Thrathra/Speeduino-Daytona/Documentation/F107VC_pinout.png

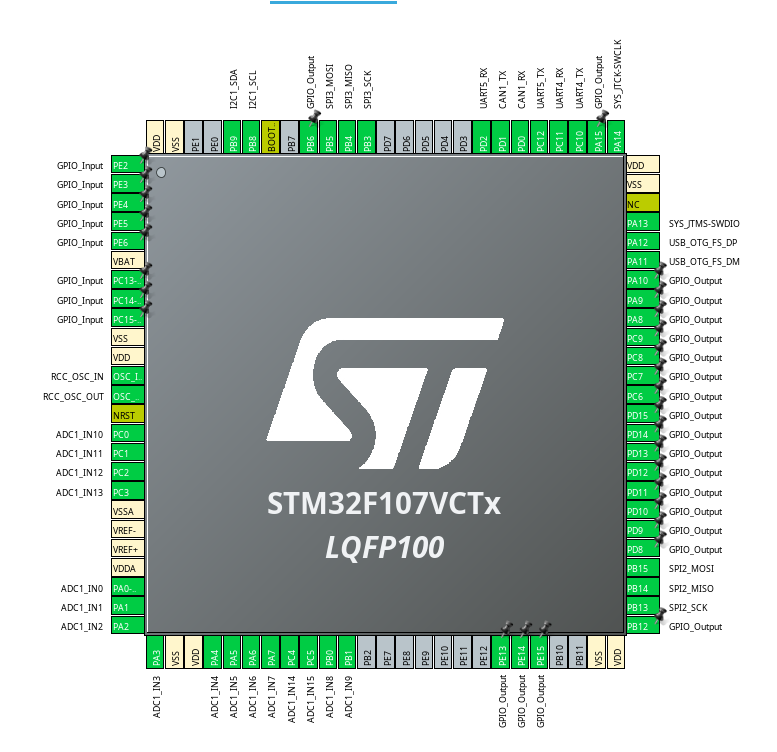
Documentation/F107VC_pinout.png
