Thrathra/Speeduino-Daytona/speeday.kicad_pcb

## KiCad design speeday.kicad_pcb (2026-07-01)

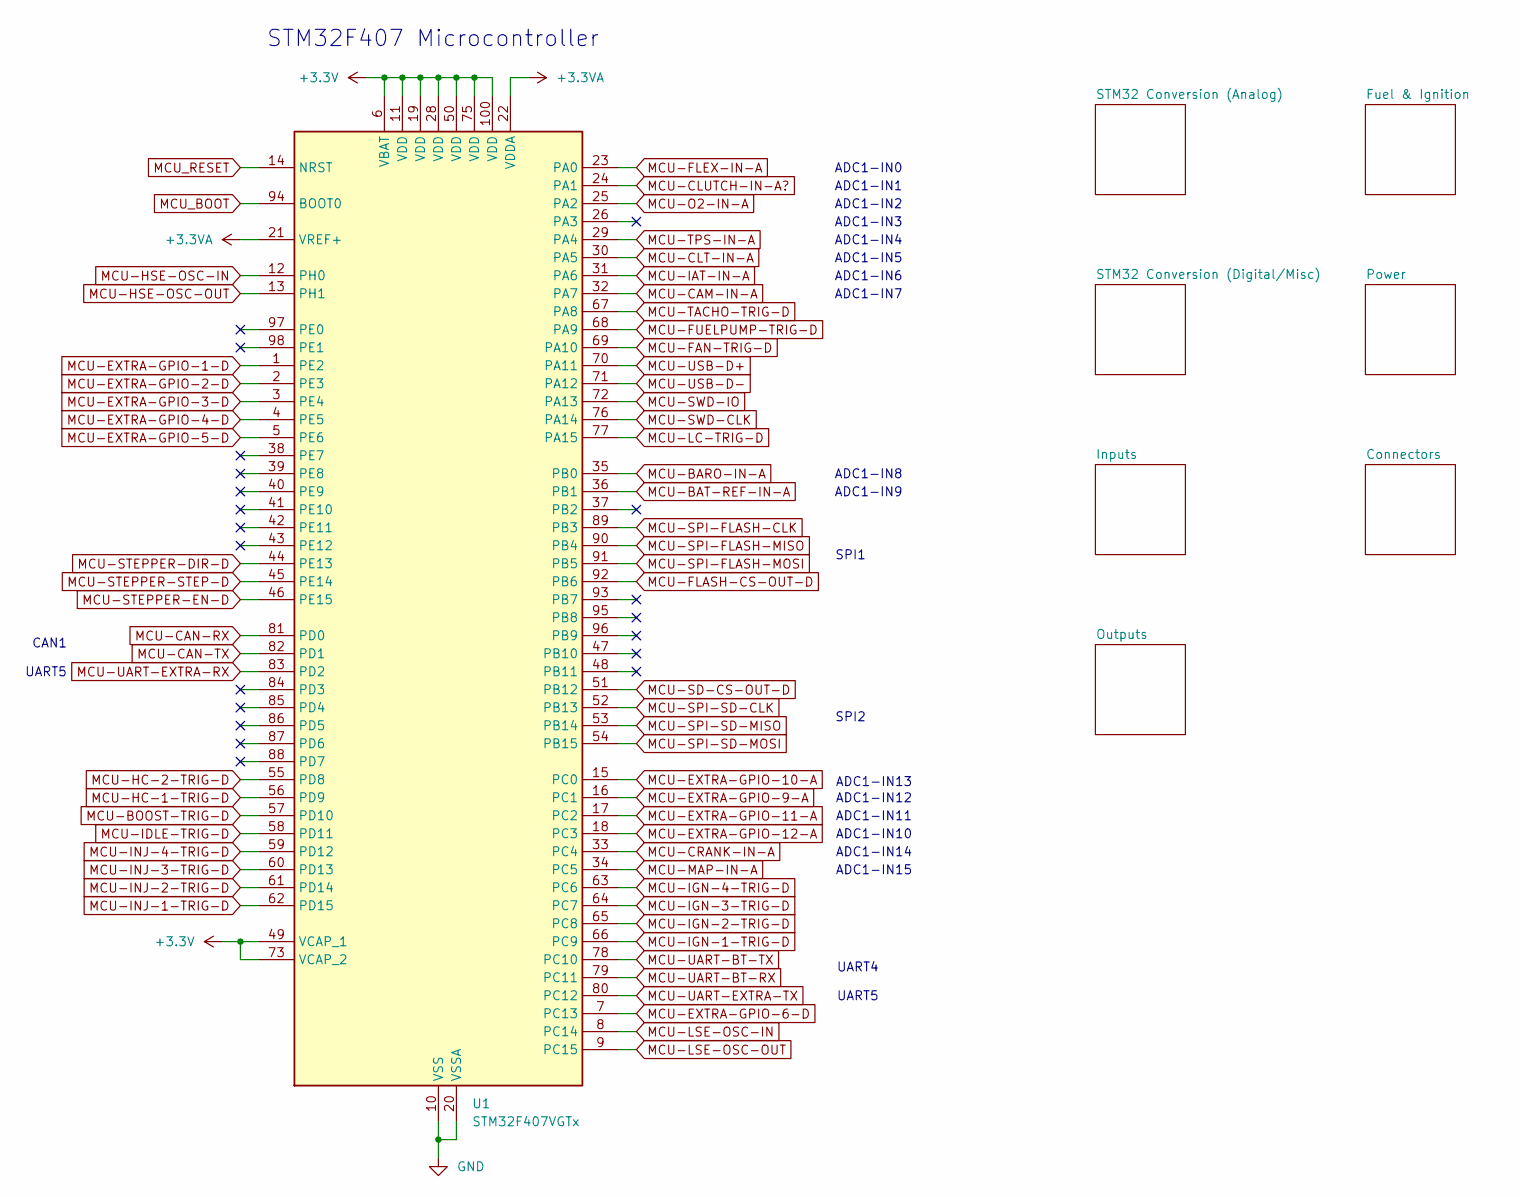
[picture p2: schematic speeday.kicad_sch, 0.4]

Parts:
U1: STM32F407VGTx; LQFP-100_14x14mm_P0.5mm

Connections:
+3.3V: U1.6 (VBAT), U1.11 (VDD), U1.19 (VDD), U1.28 (VDD), U1.49 (VCAP_1), U1.50 (VDD), U1.73 (VCAP_2), U1.75 (VDD), U1.100 (VDD); also elsewhere on the board
+3.3VA: U1.21 (VREF+), U1.22 (VDDA); also elsewhere on the board
GND: U1.10 (VSS), U1.20 (VSSA), U1.27 (VSS), U1.74 (VSS), U1.99 (VSS); also elsewhere on the board
MCU-BARO-IN-A: U1.35 (PB0); also elsewhere on the board
MCU-BAT-REF-IN-A: U1.36 (PB1); also elsewhere on the board
MCU-BOOST-TRIG-D: U1.57 (PD10); also elsewhere on the board
MCU-CAM-IN-A: U1.32 (PA7); also elsewhere on the board
MCU-CAN-RX: U1.81 (PD0); also elsewhere on the board
MCU-CAN-TX: U1.82 (PD1); also elsewhere on the board
MCU-CLT-IN-A: U1.30 (PA5); also elsewhere on the board
MCU-CLUTCH-IN-A?: U1.24 (PA1); also elsewhere on the board
MCU-CRANK-IN-A: U1.33 (PC4); also elsewhere on the board
MCU-EXTRA-GPIO-1-D: U1.1 (PE2); also elsewhere on the board
MCU-EXTRA-GPIO-2-D: U1.2 (PE3); also elsewhere on the board
MCU-EXTRA-GPIO-3-D: U1.3 (PE4); also elsewhere on the board
MCU-EXTRA-GPIO-4-D: U1.4 (PE5); also elsewhere on the board
MCU-EXTRA-GPIO-5-D: U1.5 (PE6); also elsewhere on the board
MCU-EXTRA-GPIO-6-D: U1.7 (PC13); also elsewhere on the board
MCU-EXTRA-GPIO-9-A: U1.16 (PC1); also elsewhere on the board
MCU-EXTRA-GPIO-10-A: U1.15 (PC0); also elsewhere on the board
MCU-EXTRA-GPIO-11-A: U1.17 (PC2); also elsewhere on the board
MCU-EXTRA-GPIO-12-A: U1.18 (PC3); also elsewhere on the board
MCU-FAN-TRIG-D: U1.69 (PA10); also elsewhere on the board
MCU-FLASH-CS-OUT-D: U1.92 (PB6); also elsewhere on the board
MCU-FLEX-IN-A: U1.23 (PA0); also elsewhere on the board
MCU-FUELPUMP-TRIG-D: U1.68 (PA9); also elsewhere on the board
MCU-HC-1-TRIG-D: U1.56 (PD9); also elsewhere on the board
MCU-HC-2-TRIG-D: U1.55 (PD8); also elsewhere on the board
MCU-HSE-OSC-IN: U1.12 (PH0); also elsewhere on the board
MCU-HSE-OSC-OUT: U1.13 (PH1); also elsewhere on the board
MCU-IAT-IN-A: U1.31 (PA6); also elsewhere on the board
MCU-IDLE-TRIG-D: U1.58 (PD11); also elsewhere on the board
MCU-IGN-1-TRIG-D: U1.66 (PC9); also elsewhere on the board
MCU-IGN-2-TRIG-D: U1.65 (PC8); also elsewhere on the board
MCU-IGN-3-TRIG-D: U1.64 (PC7); also elsewhere on the board
MCU-IGN-4-TRIG-D: U1.63 (PC6); also elsewhere on the board
MCU-INJ-1-TRIG-D: U1.62 (PD15); also elsewhere on the board
MCU-INJ-2-TRIG-D: U1.61 (PD14); also elsewhere on the board
MCU-INJ-3-TRIG-D: U1.60 (PD13); also elsewhere on the board
MCU-INJ-4-TRIG-D: U1.59 (PD12); also elsewhere on the board
MCU-LC-TRIG-D: U1.77 (PA15); also elsewhere on the board
MCU-LSE-OSC-IN: U1.8 (PC14); also elsewhere on the board
MCU-LSE-OSC-OUT: U1.9 (PC15); also elsewhere on the board
MCU-MAP-IN-A: U1.34 (PC5); also elsewhere on the board
MCU-O2-IN-A: U1.25 (PA2); also elsewhere on the board
MCU-SD-CS-OUT-D: U1.51 (PB12); also elsewhere on the board
MCU-SPI-FLASH-CLK: U1.89 (PB3); also elsewhere on the board
MCU-SPI-FLASH-MISO: U1.90 (PB4); also elsewhere on the board
MCU-SPI-FLASH-MOSI: U1.91 (PB5); also elsewhere on the board
MCU-SPI-SD-CLK: U1.52 (PB13); also elsewhere on the board
MCU-SPI-SD-MISO: U1.53 (PB14); also elsewhere on the board
MCU-SPI-SD-MOSI: U1.54 (PB15); also elsewhere on the board
MCU-STEPPER-DIR-D: U1.44 (PE13); also elsewhere on the board
MCU-STEPPER-EN-D: U1.46 (PE15); also elsewhere on the board
MCU-STEPPER-STEP-D: U1.45 (PE14); also elsewhere on the board
MCU-SWD-CLK: U1.76 (PA14); also elsewhere on the board
MCU-SWD-IO: U1.72 (PA13); also elsewhere on the board
MCU-TACHO-TRIG-D: U1.67 (PA8); also elsewhere on the board
MCU-TPS-IN-A: U1.29 (PA4); also elsewhere on the board
MCU-UART-BT-RX: U1.79 (PC11); also elsewhere on the board
MCU-UART-BT-TX: U1.78 (PC10); also elsewhere on the board
MCU-UART-EXTRA-RX: U1.83 (PD2); also elsewhere on the board
MCU-UART-EXTRA-TX: U1.80 (PC12); also elsewhere on the board
MCU-USB-D+: U1.70 (PA11); also elsewhere on the board
MCU-USB-D-: U1.71 (PA12); also elsewhere on the board
MCU_BOOT: U1.94 (BOOT0); also elsewhere on the board
MCU_RESET: U1.14 (NRST); also elsewhere on the board

Notes on the sheet:
SPI1
ADC1-IN3
CAN1
ADC1-IN14
ADC1-IN2
ADC1-IN5
UART5
ADC1-IN9
ADC1-IN13
ADC1-IN10
SPI2
ADC1-IN15
ADC1-IN8
ADC1-IN0
STM32F407 Microcontroller
UART4
ADC1-IN4
ADC1-IN7
ADC1-IN1
ADC1-IN12
ADC1-IN11
ADC1-IN6

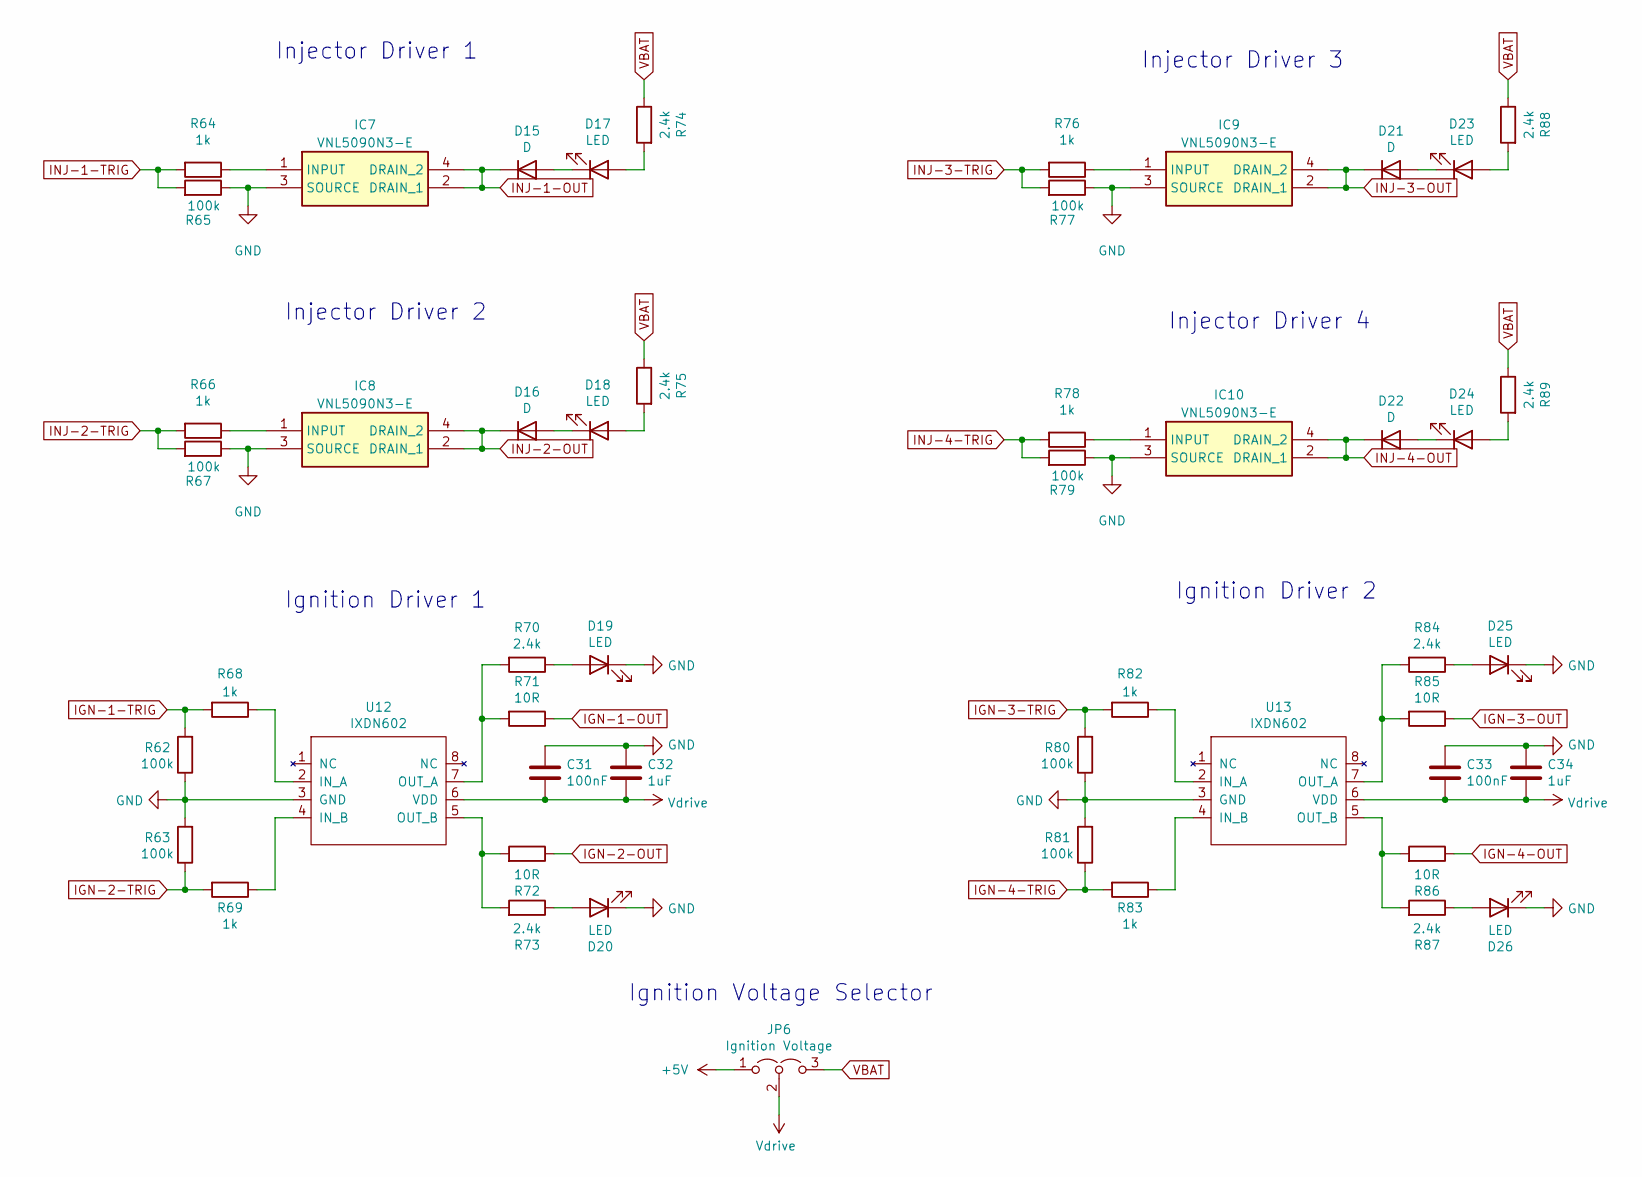
[picture p3: schematic fuel_ignition.kicad_sch, 0.4]

Parts:
C31, C33: 100nF; C_0805_2012Metric; Manufacturer_Part_Number CC0805KRX7R9BB104; Digikey Part Number 311-1140-1-ND
C32, C34: 1uF; C_0805_2012Metric; Manufacturer_Part_Number CC0805KKX7R7BB105; Digikey Part Number 311-1365-1-ND
D15, D16, D21, D22: D; D_SOD-323; Manufacturer_Part_Number 1N4448WX-TP; Digikey Part Number 1N4448WXTPMSCT-ND
D17, D18, D19, D20, D23, D24, D25, D26: LED; LED_0805_2012Metric; Manufacturer_Part_Number LH R974-LP-1; Digikey Part Number 475-1415-1-ND
IC7, IC8, IC9, IC10: VNL5090N3-E; SOT230P700X180-4N; Manufacturer_Part_Number VNL5090N3-E
JP6: Ignition Voltage; SolderJumper-3_P1.3mm_Open_RoundedPad1.0x1.5mm; Manufacturer_Part_Number M20-9990345; Digikey Part Number 952-2263-ND
R62, R63, R65, R67, R77, R79, R80, R81: 100k; R_0805_2012Metric; Manufacturer_Part_Number RC0805FR-07100KL; Digikey Part Number 311-100KCRCT-ND
R64, R66, R68, R69, R76, R78, R82, R83: 1k; R_0805_2012Metric; Manufacturer_Part_Number RC0805FR-071KL; Digikey Part Number 311-1.00KCRCT-ND
R70, R73, R74, R75, R84, R87, R88, R89: 2.4k; R_0805_2012Metric; Manufacturer_Part_Number RC0805FR-072K4L; Digikey Part Number 311-2.40KCRCT-ND
R71, R72, R85, R86: 10R; R_1206_3216Metric; Manufacturer_Part_Number RC1206FR-0710RL; Digikey Part Number 311-10.0FRCT-ND
U12, U13: IXDN602; SOIC-8_3.9x4.9mm_P1.27mm; Manufacturer_Part_Number IXDN602SIATR; Digikey Part Number 212-IXDN602SIACT-ND

Connections:
+5V: JP6.1 (A); also elsewhere on the board
GND: C31.1, C32.1, C33.1, C34.1, D19.1 (K), D20.1 (K), D25.1 (K), D26.1 (K), IC7.3 (SOURCE), IC8.3 (SOURCE), IC9.3 (SOURCE), IC10.3 (SOURCE), R62.1, R63.2, R65.1, R67.1, R77.1, R79.1, R80.1, R81.2, U12.3 (GND), U13.3 (GND); also elsewhere on the board
IGN-1-OUT: R71.1; also elsewhere on the board
IGN-1-TRIG: R62.2, R68.2; also elsewhere on the board
IGN-2-OUT: R72.1; also elsewhere on the board
IGN-2-TRIG: R63.1, R69.2; also elsewhere on the board
IGN-3-OUT: R85.1; also elsewhere on the board
IGN-3-TRIG: R80.2, R82.2; also elsewhere on the board
IGN-4-OUT: R86.1; also elsewhere on the board
IGN-4-TRIG: R81.1, R83.2; also elsewhere on the board
INJ-1-OUT: D15.1 (K), IC7.2 (DRAIN_1), IC7.4 (DRAIN_2); also elsewhere on the board
INJ-1-TRIG: R64.2, R65.2; also elsewhere on the board
INJ-2-OUT: D16.1 (K), IC8.2 (DRAIN_1), IC8.4 (DRAIN_2); also elsewhere on the board
INJ-2-TRIG: R66.2, R67.2; also elsewhere on the board
INJ-3-OUT: D21.1 (K), IC9.2 (DRAIN_1), IC9.4 (DRAIN_2); also elsewhere on the board
INJ-3-TRIG: R76.2, R77.2; also elsewhere on the board
INJ-4-OUT: D22.1 (K), IC10.2 (DRAIN_1), IC10.4 (DRAIN_2); also elsewhere on the board
INJ-4-TRIG: R78.2, R79.2; also elsewhere on the board
unnamed: D15.2 (A), D17.1 (K)
unnamed: D16.2 (A), D18.1 (K)
unnamed: D17.2 (A), R74.2
unnamed: D18.2 (A), R75.2
unnamed: D19.2 (A), R70.1
unnamed: D20.2 (A), R73.1
unnamed: D21.2 (A), D23.1 (K)
unnamed: D22.2 (A), D24.1 (K)
unnamed: D23.2 (A), R88.2
unnamed: D24.2 (A), R89.2
unnamed: D25.2 (A), R84.1
unnamed: D26.2 (A), R87.1
unnamed: IC7.1 (INPUT), R64.1
unnamed: IC8.1 (INPUT), R66.1
unnamed: IC9.1 (INPUT), R76.1
unnamed: IC10.1 (INPUT), R78.1
unnamed: R68.1, U12.2 (IN_A)
unnamed: R69.1, U12.4 (IN_B)
unnamed: R70.2, R71.2, U12.7 (OUT_A)
unnamed: R72.2, R73.2, U12.5 (OUT_B)
unnamed: R82.1, U13.2 (IN_A)
unnamed: R83.1, U13.4 (IN_B)
unnamed: R84.2, R85.2, U13.7 (OUT_A)
unnamed: R86.2, R87.2, U13.5 (OUT_B)
VBAT: JP6.3 (B), R74.1, R75.1, R88.1, R89.1; also elsewhere on the board
Vdrive: C31.2, C32.2, C33.2, C34.2, JP6.2 (C), U12.6 (VDD), U13.6 (VDD)

Notes on the sheet:
Ignition Voltage Selector
Injector Driver 4
Injector Driver 2
Ignition Driver 2
Injector Driver 1
Injector Driver 3
Ignition Driver 1

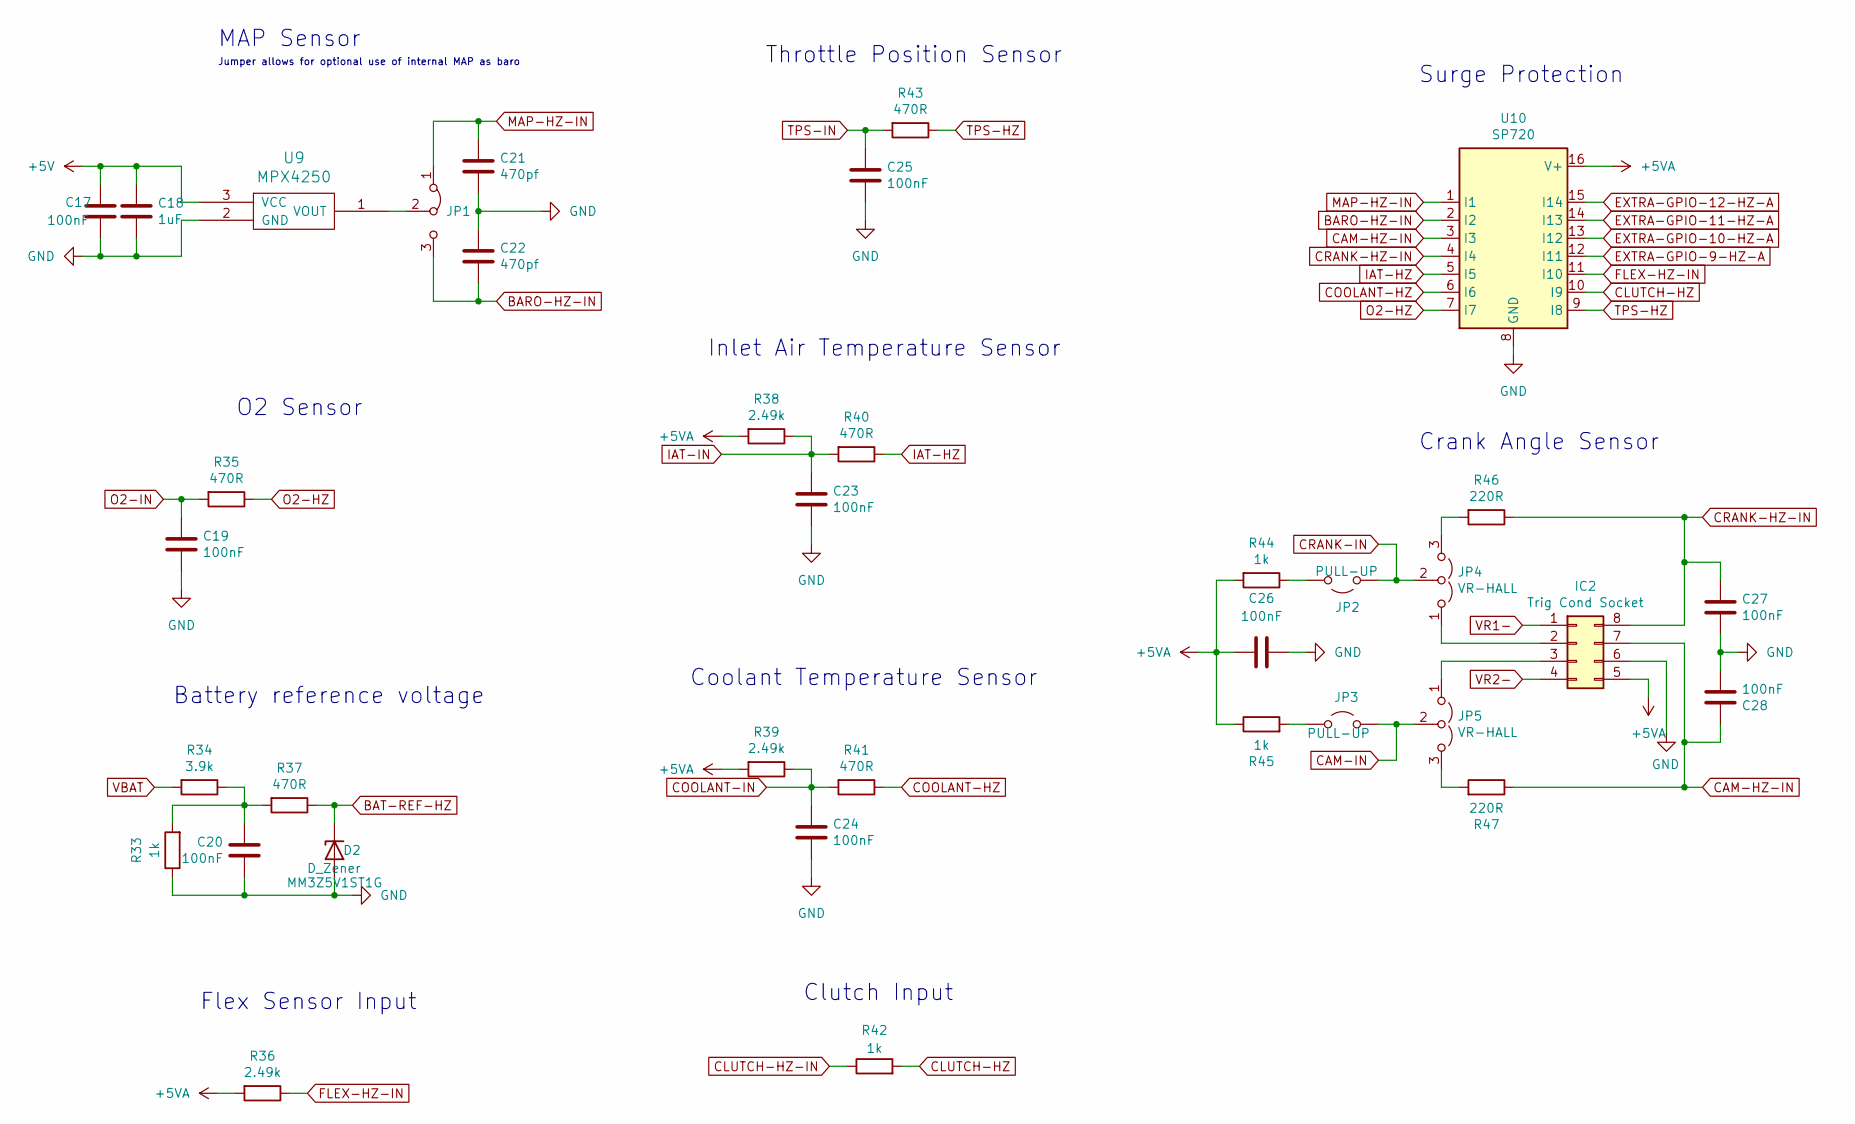
[picture p4: schematic inputs.kicad_sch, 0.4]

Parts:
C17, C27: 100nF; C_0805_2012Metric; Manufacturer_Part_Number CC0805KRX7R9BB103; Digikey Part Number 311-1136-1-ND
C18: 1uF; C_0805_2012Metric; Manufacturer_Part_Number CC0805KKX7R7BB105; Digikey Part Number 311-1365-1-ND
C19, C20, C23, C24, C25, C28: 100nF; C_0805_2012Metric; Manufacturer_Part_Number CC0805KRX7R9BB104; Digikey Part Number 311-1140-1-ND
C21, C22: 470pf; C_0805_2012Metric; Manufacturer_Part_Number CC0805KRX7R9BB471; Digikey Part Number 311-1124-1-ND
C26: 100nF; C_0805_2012Metric
D2: D_Zener; D_SOD-323; Part # MM3Z5V1ST1G; Digikey Part Number MM3Z5V1ST1GOSCT-ND
IC2: Trig Cond Socket; DIP-8_W7.62mm_Socket
JP1: Jumper_3_Bridged12; SolderJumper-3_P1.3mm_Open_RoundedPad1.0x1.5mm
JP2, JP3: PULL-UP; SolderJumper-2_P1.3mm_Open_RoundedPad1.0x1.5mm; Manufacturer_Part_Number M20-9990245; Digikey Part Number 952-2261-ND
JP4, JP5: VR-HALL; SolderJumper-3_P1.3mm_Open_RoundedPad1.0x1.5mm; Manufacturer_Part_Number M20-9990345; Digikey Part Number 952-2263-ND
R33, R42, R44, R45: 1k; R_0805_2012Metric; Manufacturer_Part_Number RC0805FR-071KL; Digikey Part Number 311-1.00KCRCT-ND
R34: 3.9k; R_0805_2012Metric; Manufacturer_Part_Number RC0805FR-073K9L; Digikey Part Number 311-3.90KCRCT-ND
R35, R37, R40, R41, R43: 470R; R_0805_2012Metric; Manufacturer_Part_Number ERJ-6ENF4700V; Digikey Part Number P470CCT-ND
R36: 2.49k; R_0805_2012Metric; Manufacturer_Part_Number RC0805FR-072K4L; Digikey Part Number 311-2.40KCRCT-ND
R38, R39: 2.49k; R_0805_2012Metric; Manufacturer_Part_Number RT0805BRD072K49L; Digikey Part Number YAG1854CT-ND
R46, R47: 220R; R_0805_2012Metric; Manufacturer_Part_Number RC0805FR-07220RL; Digikey Part Number 311-220CRCT-ND
U9: MPX4250; Manufacturer_Part_Number MPX4250AP; Digikey Part Number MPX4250AP-ND
U10: SP720; SOIC-16_3.9x9.9mm_P1.27mm; Manufacturer_Part_Number SP720ABTG; Digikey Part Number F3162CT-ND

Connections:
+5V: C17.1, C18.1, U9.3 (VCC); also elsewhere on the board
+5VA: C26.1, IC2.5, R36.2, R38.2, R39.2, R44.2, R45.1, U10.16 (V+); also elsewhere on the board
BARO-HZ-IN: C22.2, JP1.3 (B), U10.2 (I2); also elsewhere on the board
BAT-REF-HZ: D2.1 (K), R37.1; also elsewhere on the board
CAM-HZ-IN: C28.1, IC2.7, R47.1, U10.3 (I3); also elsewhere on the board
CAM-IN: JP3.2 (B), JP5.2 (C); also elsewhere on the board
CLUTCH-HZ: R42.2, U10.10 (I9); also elsewhere on the board
CLUTCH-HZ-IN: R42.1; also elsewhere on the board
COOLANT-HZ: R41.1, U10.6 (I6); also elsewhere on the board
COOLANT-IN: C24.1, R39.1, R41.2; also elsewhere on the board
CRANK-HZ-IN: C27.1, IC2.8, R46.1, U10.4 (I4); also elsewhere on the board
CRANK-IN: JP2.1 (A), JP4.2 (C); also elsewhere on the board
EXTRA-GPIO-9-HZ-A: U10.12 (I11); also elsewhere on the board
EXTRA-GPIO-10-HZ-A: U10.13 (I12); also elsewhere on the board
EXTRA-GPIO-11-HZ-A: U10.14 (I13); also elsewhere on the board
EXTRA-GPIO-12-HZ-A: U10.15 (I14); also elsewhere on the board
FLEX-HZ-IN: R36.1, U10.11 (I10); also elsewhere on the board
GND: C17.2, C18.2, C19.2, C20.2, C21.2, C22.1, C23.2, C24.2, C25.2, C26.2, C27.2, C28.2, D2.2 (A), IC2.6, R33.1, U9.2 (GND), U10.8 (GND); also elsewhere on the board
IAT-HZ: R40.1, U10.5 (I5); also elsewhere on the board
IAT-IN: C23.1, R38.1, R40.2; also elsewhere on the board
MAP-HZ-IN: C21.1, JP1.1 (A), U10.1 (I1); also elsewhere on the board
unnamed: C20.1, R33.2, R34.1, R37.2
unnamed: IC2.2, JP4.1 (A)
unnamed: IC2.3, JP5.1 (A)
unnamed: JP1.2 (C), U9.1 (VOUT)
unnamed: JP2.2 (B), R44.1
unnamed: JP3.1 (A), R45.2
unnamed: JP4.3 (B), R46.2
unnamed: JP5.3 (B), R47.2
O2-HZ: R35.1, U10.7 (I7); also elsewhere on the board
O2-IN: C19.1, R35.2; also elsewhere on the board
TPS-HZ: R43.1, U10.9 (I8); also elsewhere on the board
TPS-IN: C25.1, R43.2; also elsewhere on the board
VBAT: R34.2; also elsewhere on the board
VR1-: IC2.1; also elsewhere on the board
VR2-: IC2.4; also elsewhere on the board

Notes on the sheet:
Jumper allows for optional use of internal MAP as baro
Crank Angle Sensor
Battery reference voltage
O2 Sensor
Inlet Air Temperature Sensor
Surge Protection
Throttle Position Sensor
Flex Sensor Input
Clutch Input
MAP Sensor
Coolant Temperature Sensor

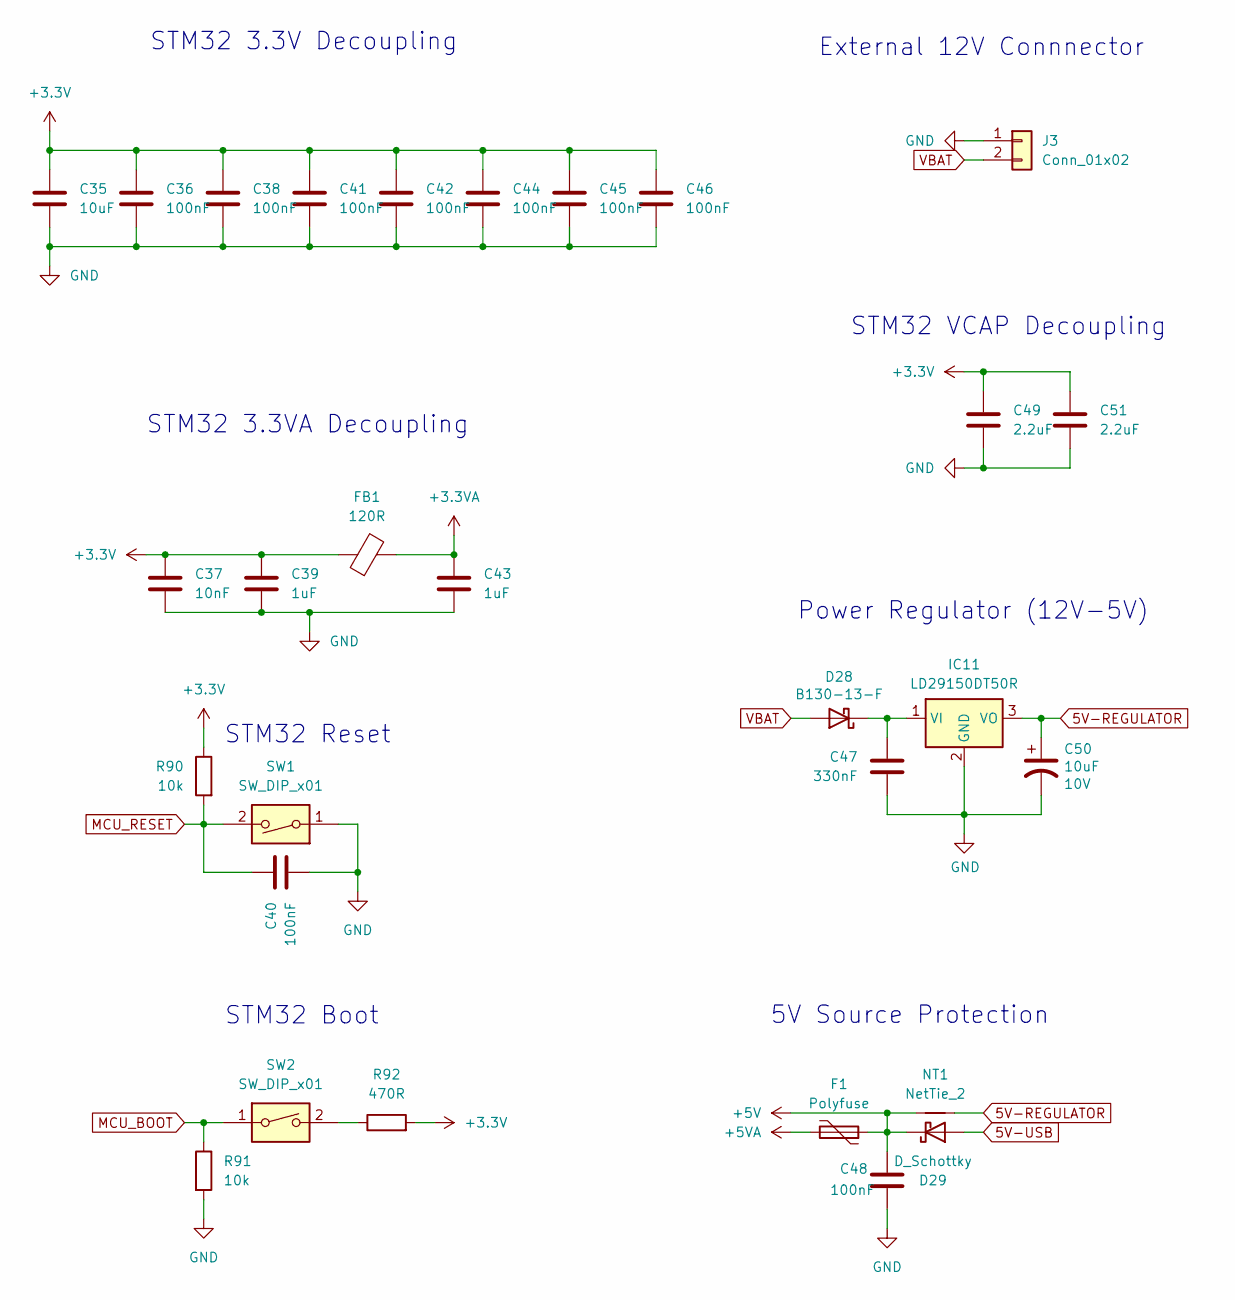
[picture p5: schematic power.kicad_sch, 0.4]

Parts:
C35: 10uF; C_0805_2012Metric
C36, C38, C40, C41, C42, C44, C45, C46: 100nF; C_0805_2012Metric
C37: 10nF; C_0805_2012Metric
C39, C43: 1uF; C_0805_2012Metric
C47: 330nF; C_0805_2012Metric; Voltage 25V
C48: 100nF; C_0805_2012Metric; Manufacturer_Part_Number CC0805KRX7R9BB104; Digikey Part Number 311-1140-1-ND
C49, C51: 2.2uF; C_0805_2012Metric
C50: 10uF; CP_EIA-3528-12_Kemet-T; Voltage 10V; Manufacturer_Part_Number TAJB476K006RNJ; Digikey Part Number 478-1692-1-ND
D28: B130-13-F; D_SMA; Manufacturer_Part_Number B130-13-F; Digikey Part Number B130-FDICT-ND
D29: D_Schottky; D_SOD-323
F1: Polyfuse; Fuse_1812_4532Metric
FB1: 120R; L_0805_2012Metric
IC11: LD29150DT50R; TO-252-2; Manufacturer_Part_Number LD29150DT50R; Mouser Part Number 511-LD29150DT50R
J3: Conn_01x02; AMASS_XT30U-F_1x02_P5.0mm_Vertical
NT1: NetTie_2; NetTie-2_SMD_Pad0.5mm
R90, R91: 10k; R_0805_2012Metric
R92: 470R; R_0805_2012Metric
SW1, SW2: SW_DIP_x01; SW_SPST_B3U-1000P

Connections:
5V-REGULATOR: C50.1, IC11.3 (VO), NT1.2
5V-USB: D29.2 (A); also elsewhere on the board
+3.3V: C35.1, C36.1, C37.1, C38.1, C39.1, C41.1, C42.1, C44.1, C45.1, C46.1, C49.1, C51.1, FB1.1, R90.1, R92.2; also elsewhere on the board
+3.3VA: C43.1, FB1.2; also elsewhere on the board
+5V: C48.1, D29.1 (K), F1.1, NT1.1; also elsewhere on the board
+5VA: F1.2; also elsewhere on the board
GND: C35.2, C36.2, C37.2, C38.2, C39.2, C40.2, C41.2, C42.2, C43.2, C44.2, C45.2, C46.2, C47.2, C48.2, C49.2, C50.2, C51.2, IC11.2 (GND), J3.1, R91.2, SW1.1; also elsewhere on the board
MCU_BOOT: R91.1, SW2.1; also elsewhere on the board
MCU_RESET: C40.1, R90.2, SW1.2; also elsewhere on the board
unnamed: C47.1, D28.1 (K), IC11.1 (VI)
unnamed: R92.1, SW2.2
VBAT: D28.2 (A), J3.2; also elsewhere on the board

Notes on the sheet:
5V Source Protection
STM32 3.3VA Decoupling
External 12V Connnector
STM32 VCAP Decoupling
STM32 3.3V Decoupling
Power Regulator (12V-5V)
STM32 Boot
STM32 Reset

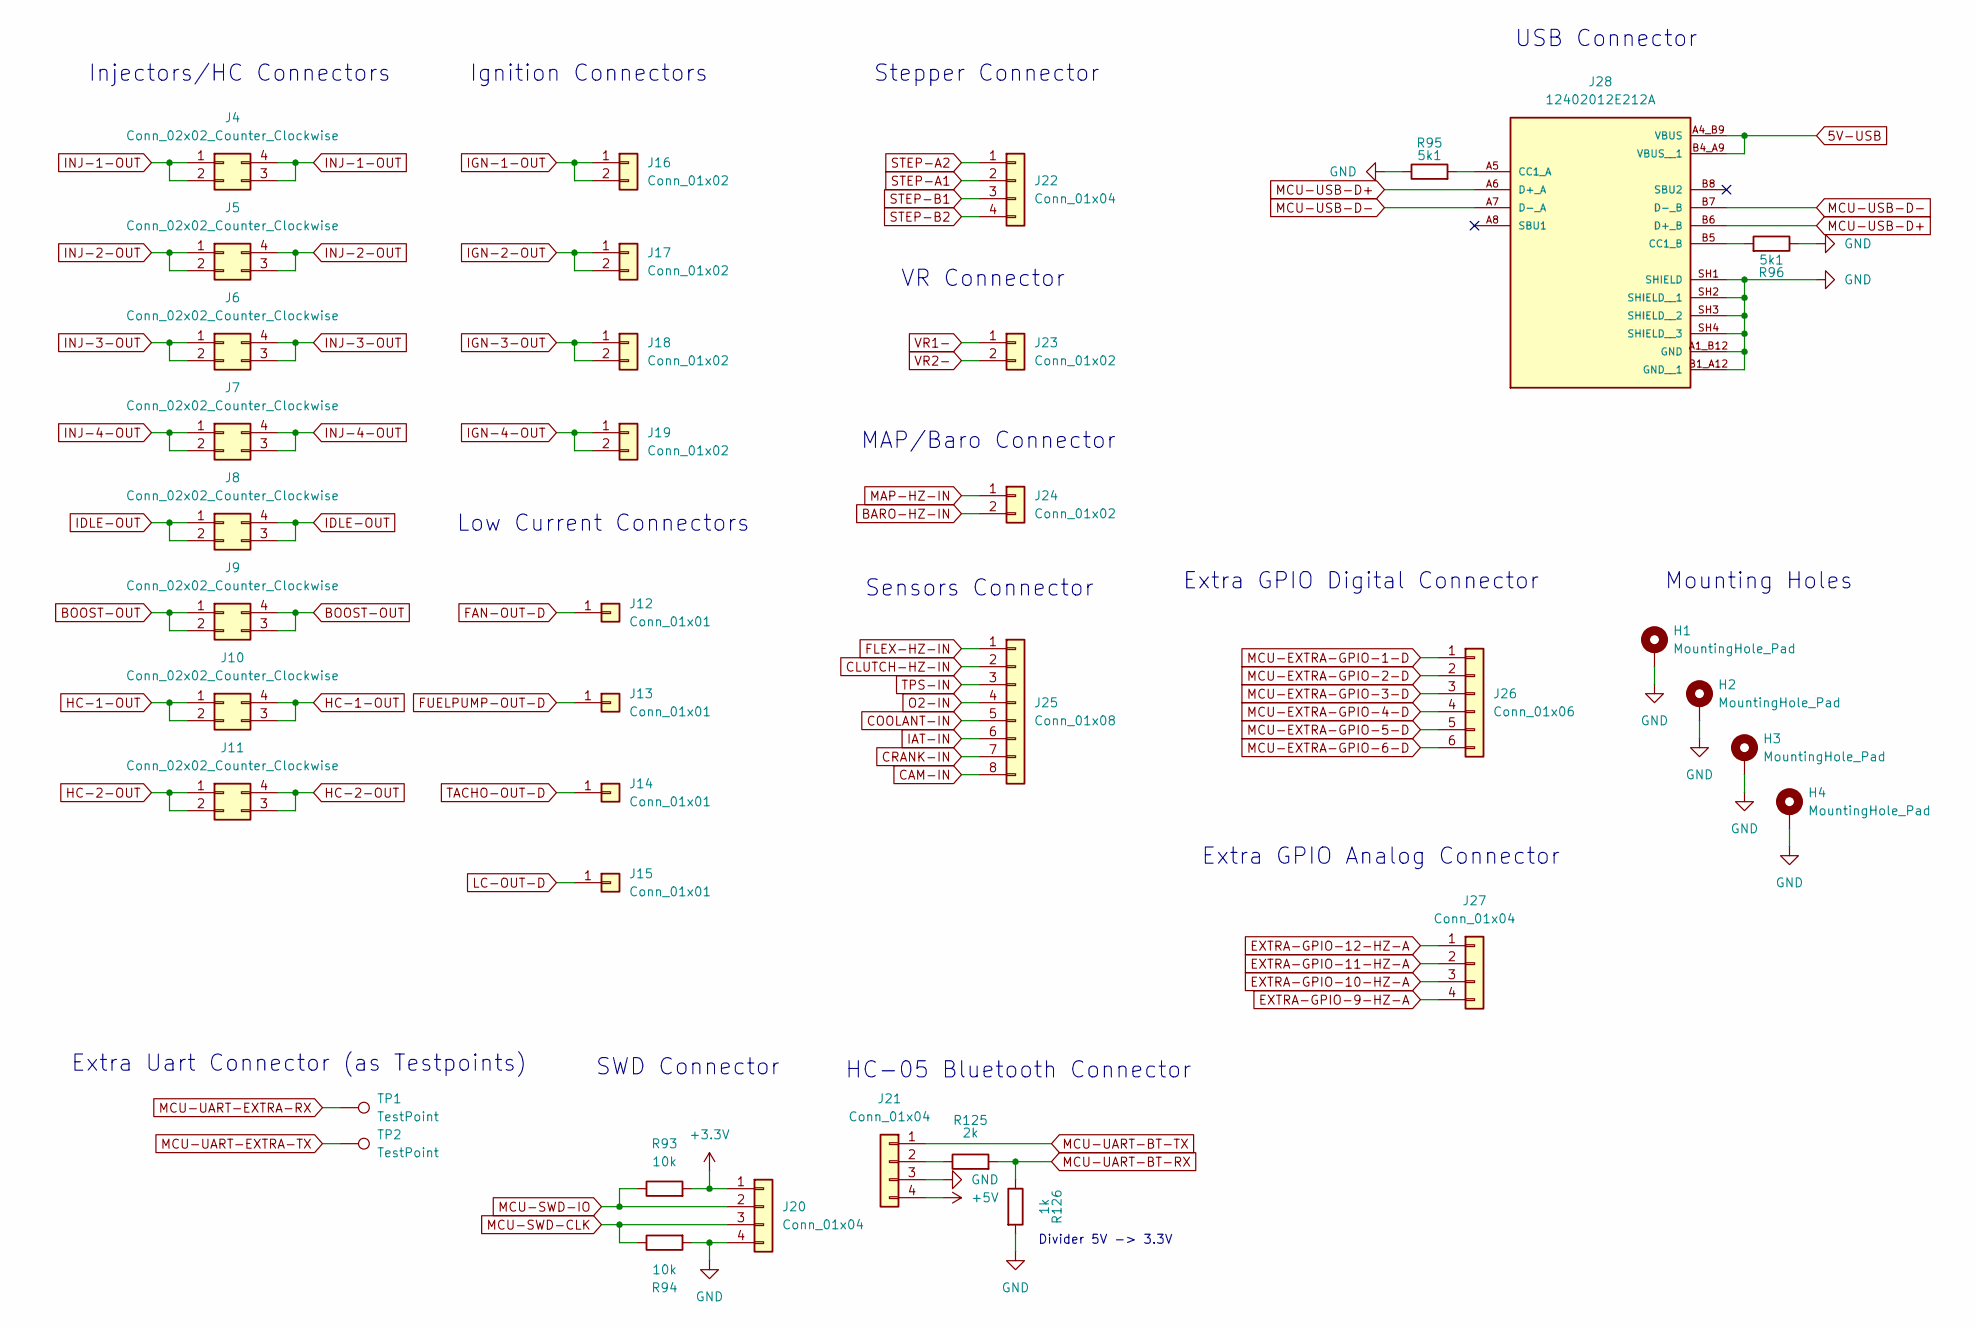
[picture p6: schematic connectors.kicad_sch, 0.4]

Parts:
H1, H2, H3, H4: MountingHole_Pad; MountingHole_4mm_Pad
J4, J5, J6, J7, J8, J9, J10, J11: Conn_02x02_Counter_Clockwise; PinHeader_2x02_P2.54mm_Vertical
J12, J13, J14, J15: Conn_01x01; PinHeader_1x01_P2.54mm_Vertical
J16, J17, J18, J19, J23, J24: Conn_01x02; PinHeader_1x02_P2.54mm_Vertical
J20, J21, J22, J27: Conn_01x04; PinHeader_1x04_P2.54mm_Vertical
J25: Conn_01x08; PinHeader_1x08_P2.54mm_Vertical
J26: Conn_01x06; PinHeader_1x06_P2.54mm_Vertical
J28: 12402012E212A; AMPHENOL_12402012E212A; PARTREV 4
R93, R94: 10k; R_0805_2012Metric
R95, R96: 5k1; R_0805_2012Metric
R125: 2k; R_0805_2012Metric
R126: 1k; R_0805_2012Metric
TP1, TP2: TestPoint; TestPoint_Pad_D1.0mm

Connections:
5V-USB: J28.A4_B9 (VBUS), J28.B4_A9 (VBUS__1); also elsewhere on the board
+3.3V: J20.1, R93.2; also elsewhere on the board
+5V: J21.4; also elsewhere on the board
BARO-HZ-IN: J24.2; also elsewhere on the board
BOOST-OUT: J9.1, J9.2, J9.3, J9.4; also elsewhere on the board
CAM-IN: J25.8; also elsewhere on the board
CLUTCH-HZ-IN: J25.2; also elsewhere on the board
COOLANT-IN: J25.5; also elsewhere on the board
CRANK-IN: J25.7; also elsewhere on the board
EXTRA-GPIO-9-HZ-A: J27.4; also elsewhere on the board
EXTRA-GPIO-10-HZ-A: J27.3; also elsewhere on the board
EXTRA-GPIO-11-HZ-A: J27.2; also elsewhere on the board
EXTRA-GPIO-12-HZ-A: J27.1; also elsewhere on the board
FAN-OUT-D: J12.1 (Pin_1_1); also elsewhere on the board
FLEX-HZ-IN: J25.1; also elsewhere on the board
FUELPUMP-OUT-D: J13.1 (Pin_1_1); also elsewhere on the board
GND: H1.1 (1_1), H2.1 (1_1), H3.1 (1_1), H4.1 (1_1), J20.4, J21.3, J28.A1_B12 (GND), J28.B1_A12 (GND__1), J28.SH1 (SHIELD), J28.SH2 (SHIELD__1), J28.SH3 (SHIELD__2), J28.SH4 (SHIELD__3), R94.2, R95.1, R96.1, R126.2; also elsewhere on the board
HC-1-OUT: J10.1, J10.2, J10.3, J10.4; also elsewhere on the board
HC-2-OUT: J11.1, J11.2, J11.3, J11.4; also elsewhere on the board
IAT-IN: J25.6; also elsewhere on the board
IDLE-OUT: J8.1, J8.2, J8.3, J8.4; also elsewhere on the board
IGN-1-OUT: J16.1, J16.2; also elsewhere on the board
IGN-2-OUT: J17.1, J17.2; also elsewhere on the board
IGN-3-OUT: J18.1, J18.2; also elsewhere on the board
IGN-4-OUT: J19.1, J19.2; also elsewhere on the board
INJ-1-OUT: J4.1, J4.2, J4.3, J4.4; also elsewhere on the board
INJ-2-OUT: J5.1, J5.2, J5.3, J5.4; also elsewhere on the board
INJ-3-OUT: J6.1, J6.2, J6.3, J6.4; also elsewhere on the board
INJ-4-OUT: J7.1, J7.2, J7.3, J7.4; also elsewhere on the board
LC-OUT-D: J15.1 (Pin_1_1); also elsewhere on the board
MAP-HZ-IN: J24.1; also elsewhere on the board
MCU-EXTRA-GPIO-1-D: J26.1; also elsewhere on the board
MCU-EXTRA-GPIO-2-D: J26.2; also elsewhere on the board
MCU-EXTRA-GPIO-3-D: J26.3; also elsewhere on the board
MCU-EXTRA-GPIO-4-D: J26.4; also elsewhere on the board
MCU-EXTRA-GPIO-5-D: J26.5; also elsewhere on the board
MCU-EXTRA-GPIO-6-D: J26.6; also elsewhere on the board
MCU-SWD-CLK: J20.3, R94.1; also elsewhere on the board
MCU-SWD-IO: J20.2, R93.1; also elsewhere on the board
MCU-UART-BT-RX: R125.2, R126.1; also elsewhere on the board
MCU-UART-BT-TX: J21.1; also elsewhere on the board
MCU-UART-EXTRA-RX: TP1.1 (1_1); also elsewhere on the board
MCU-UART-EXTRA-TX: TP2.1 (1_1); also elsewhere on the board
MCU-USB-D+: J28.A6 (D+_A), J28.B6 (D+_B); also elsewhere on the board
MCU-USB-D-: J28.A7 (D-_A), J28.B7 (D-_B); also elsewhere on the board
unnamed: J21.2, R125.1
unnamed: J28.A5 (CC1_A), R95.2
unnamed: J28.B5 (CC1_B), R96.2
O2-IN: J25.4; also elsewhere on the board
STEP-A1: J22.2; also elsewhere on the board
STEP-A2: J22.1; also elsewhere on the board
STEP-B1: J22.3; also elsewhere on the board
STEP-B2: J22.4; also elsewhere on the board
TACHO-OUT-D: J14.1 (Pin_1_1); also elsewhere on the board
TPS-IN: J25.3; also elsewhere on the board
VR1-: J23.1; also elsewhere on the board
VR2-: J23.2; also elsewhere on the board

Notes on the sheet:
Extra GPIO Analog Connector
Injectors/HC Connectors
Stepper Connector
Divider 5V -> 3.3V
Sensors Connector
VR Connector
Low Current Connectors
Extra GPIO Digital Connector
Mounting Holes
SWD Connector
MAP/Baro Connector
USB Connector
Ignition Connectors
Extra Uart Connector (as Testpoints)
HC-05 Bluetooth Connector
