Thrathra/Speeduino-Daytona/speeday.kicad_pcb

## KiCad design speeday.kicad_pcb (continued)

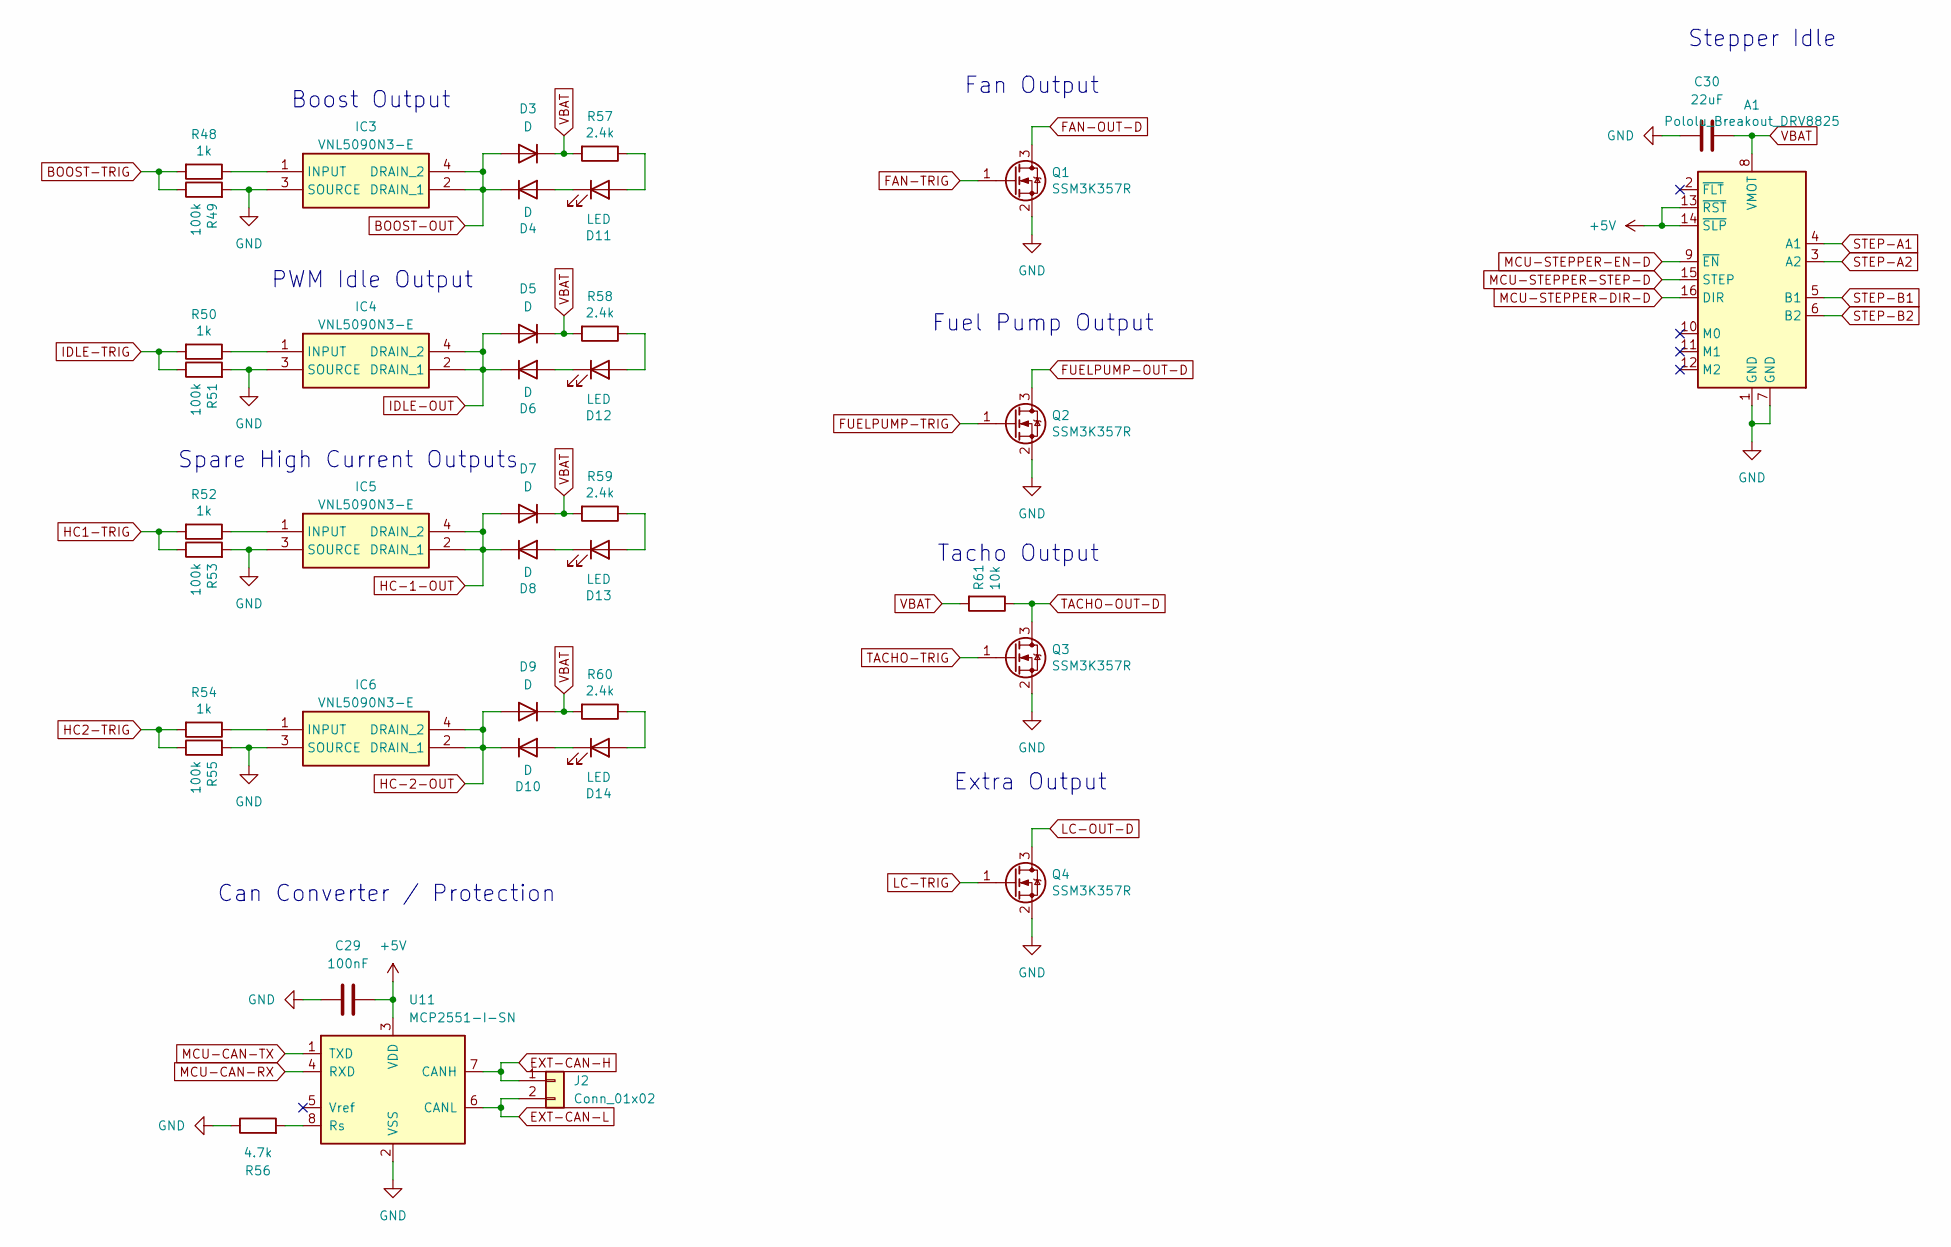
[picture p7: schematic outputs.kicad_sch, 0.4]

Parts:
A1: Pololu_Breakout_DRV8825; Pololu_Breakout-16_15.2x20.3mm
C29: 100nF; C_0805_2012Metric
C30: 22uF; C_0805_2012Metric
D3, D5, D7, D9: D; D_SOD-323
D4, D6, D8, D10: D; D_SOD-323; Manufacturer_Part_Number 1N4448WX-TP; Digikey Part Number 1N4448WXTPMSCT-ND
D11, D12, D13, D14: LED; LED_0805_2012Metric; Manufacturer_Part_Number LH R974-LP-1; Digikey Part Number 475-1415-1-ND
IC3, IC4, IC5, IC6: VNL5090N3-E; SOT230P700X180-4N; Manufacturer_Part_Number VNL5090N3-E
J2: Conn_01x02; PinHeader_1x02_P2.54mm_Vertical
Q1, Q2, Q3, Q4: SSM3K357R; SOT-23; Manufacturer_Part_Number SSM3K357R; Digikey Part Number SSM3K357RLFCT-ND
R48, R50, R52, R54: 1k; R_0805_2012Metric; Manufacturer_Part_Number RC0805FR-071KL; Digikey Part Number 311-1.00KCRCT-ND
R49, R51, R53, R55: 100k; R_0805_2012Metric; Manufacturer_Part_Number RC0805FR-07100KL; Digikey Part Number 311-100KCRCT-ND
R56: 4.7k; R_0805_2012Metric
R57, R58, R59, R60: 2.4k; R_0805_2012Metric; Manufacturer_Part_Number RC0805FR-072K4L; Digikey Part Number 311-2.40KCRCT-ND
R61: 10k; R_0805_2012Metric; Manufacturer_Part_Number RC0805JR-0710KL; Digikey Part Number 311-10KARCT-ND
U11: MCP2551-I-SN; SOIC-8_3.9x4.9mm_P1.27mm

Connections:
+5V: A1.13 (~RST), A1.14 (~SLP), C29.2, U11.3 (VDD); also elsewhere on the board
BOOST-OUT: D3.2 (A), D4.1 (K), IC3.2 (DRAIN_1), IC3.4 (DRAIN_2); also elsewhere on the board
BOOST-TRIG: R48.2, R49.1; also elsewhere on the board
EXT-CAN-H: J2.1, U11.7 (CANH)
EXT-CAN-L: J2.2, U11.6 (CANL)
FAN-OUT-D: Q1.3 (D); also elsewhere on the board
FAN-TRIG: Q1.1 (G); also elsewhere on the board
FUELPUMP-OUT-D: Q2.3 (D); also elsewhere on the board
FUELPUMP-TRIG: Q2.1 (G); also elsewhere on the board
GND: A1.1 (GND), A1.7 (GND), C29.1, C30.1, IC3.3 (SOURCE), IC4.3 (SOURCE), IC5.3 (SOURCE), IC6.3 (SOURCE), Q1.2 (S), Q2.2 (S), Q3.2 (S), Q4.2 (S), R49.2, R51.2, R53.2, R55.2, R56.1, U11.2 (VSS); also elsewhere on the board
HC1-TRIG: R52.2, R53.1; also elsewhere on the board
HC2-TRIG: R54.2, R55.1; also elsewhere on the board
HC-1-OUT: D7.2 (A), D8.1 (K), IC5.2 (DRAIN_1), IC5.4 (DRAIN_2); also elsewhere on the board
HC-2-OUT: D9.2 (A), D10.1 (K), IC6.2 (DRAIN_1), IC6.4 (DRAIN_2); also elsewhere on the board
IDLE-OUT: D5.2 (A), D6.1 (K), IC4.2 (DRAIN_1), IC4.4 (DRAIN_2); also elsewhere on the board
IDLE-TRIG: R50.2, R51.1; also elsewhere on the board
LC-OUT-D: Q4.3 (D); also elsewhere on the board
LC-TRIG: Q4.1 (G); also elsewhere on the board
MCU-CAN-RX: U11.4 (RXD); also elsewhere on the board
MCU-CAN-TX: U11.1 (TXD); also elsewhere on the board
MCU-STEPPER-DIR-D: A1.16 (DIR); also elsewhere on the board
MCU-STEPPER-EN-D: A1.9 (~EN); also elsewhere on the board
MCU-STEPPER-STEP-D: A1.15 (STEP); also elsewhere on the board
unnamed: D10.2 (A), D14.1 (K)
unnamed: D11.2 (A), R57.1
unnamed: D4.2 (A), D11.1 (K)
unnamed: D12.2 (A), R58.1
unnamed: D6.2 (A), D12.1 (K)
unnamed: D13.2 (A), R59.1
unnamed: D8.2 (A), D13.1 (K)
unnamed: D14.2 (A), R60.1
unnamed: IC3.1 (INPUT), R48.1
unnamed: IC4.1 (INPUT), R50.1
unnamed: IC5.1 (INPUT), R52.1
unnamed: IC6.1 (INPUT), R54.1
unnamed: R56.2, U11.8 (Rs)
STEP-A1: A1.4 (A1); also elsewhere on the board
STEP-A2: A1.3 (A2); also elsewhere on the board
STEP-B1: A1.5 (B1); also elsewhere on the board
STEP-B2: A1.6 (B2); also elsewhere on the board
TACHO-OUT-D: Q3.3 (D), R61.1; also elsewhere on the board
TACHO-TRIG: Q3.1 (G); also elsewhere on the board
VBAT: A1.8 (VMOT), C30.2, D3.1 (K), D5.1 (K), D7.1 (K), D9.1 (K), R57.2, R58.2, R59.2, R60.2, R61.2; also elsewhere on the board

Notes on the sheet:
Stepper Idle
Extra Output
PWM Idle Output
Spare High Current Outputs
Fan Output
Fuel Pump Output
Boost Output
Tacho Output
Can Converter / Protection

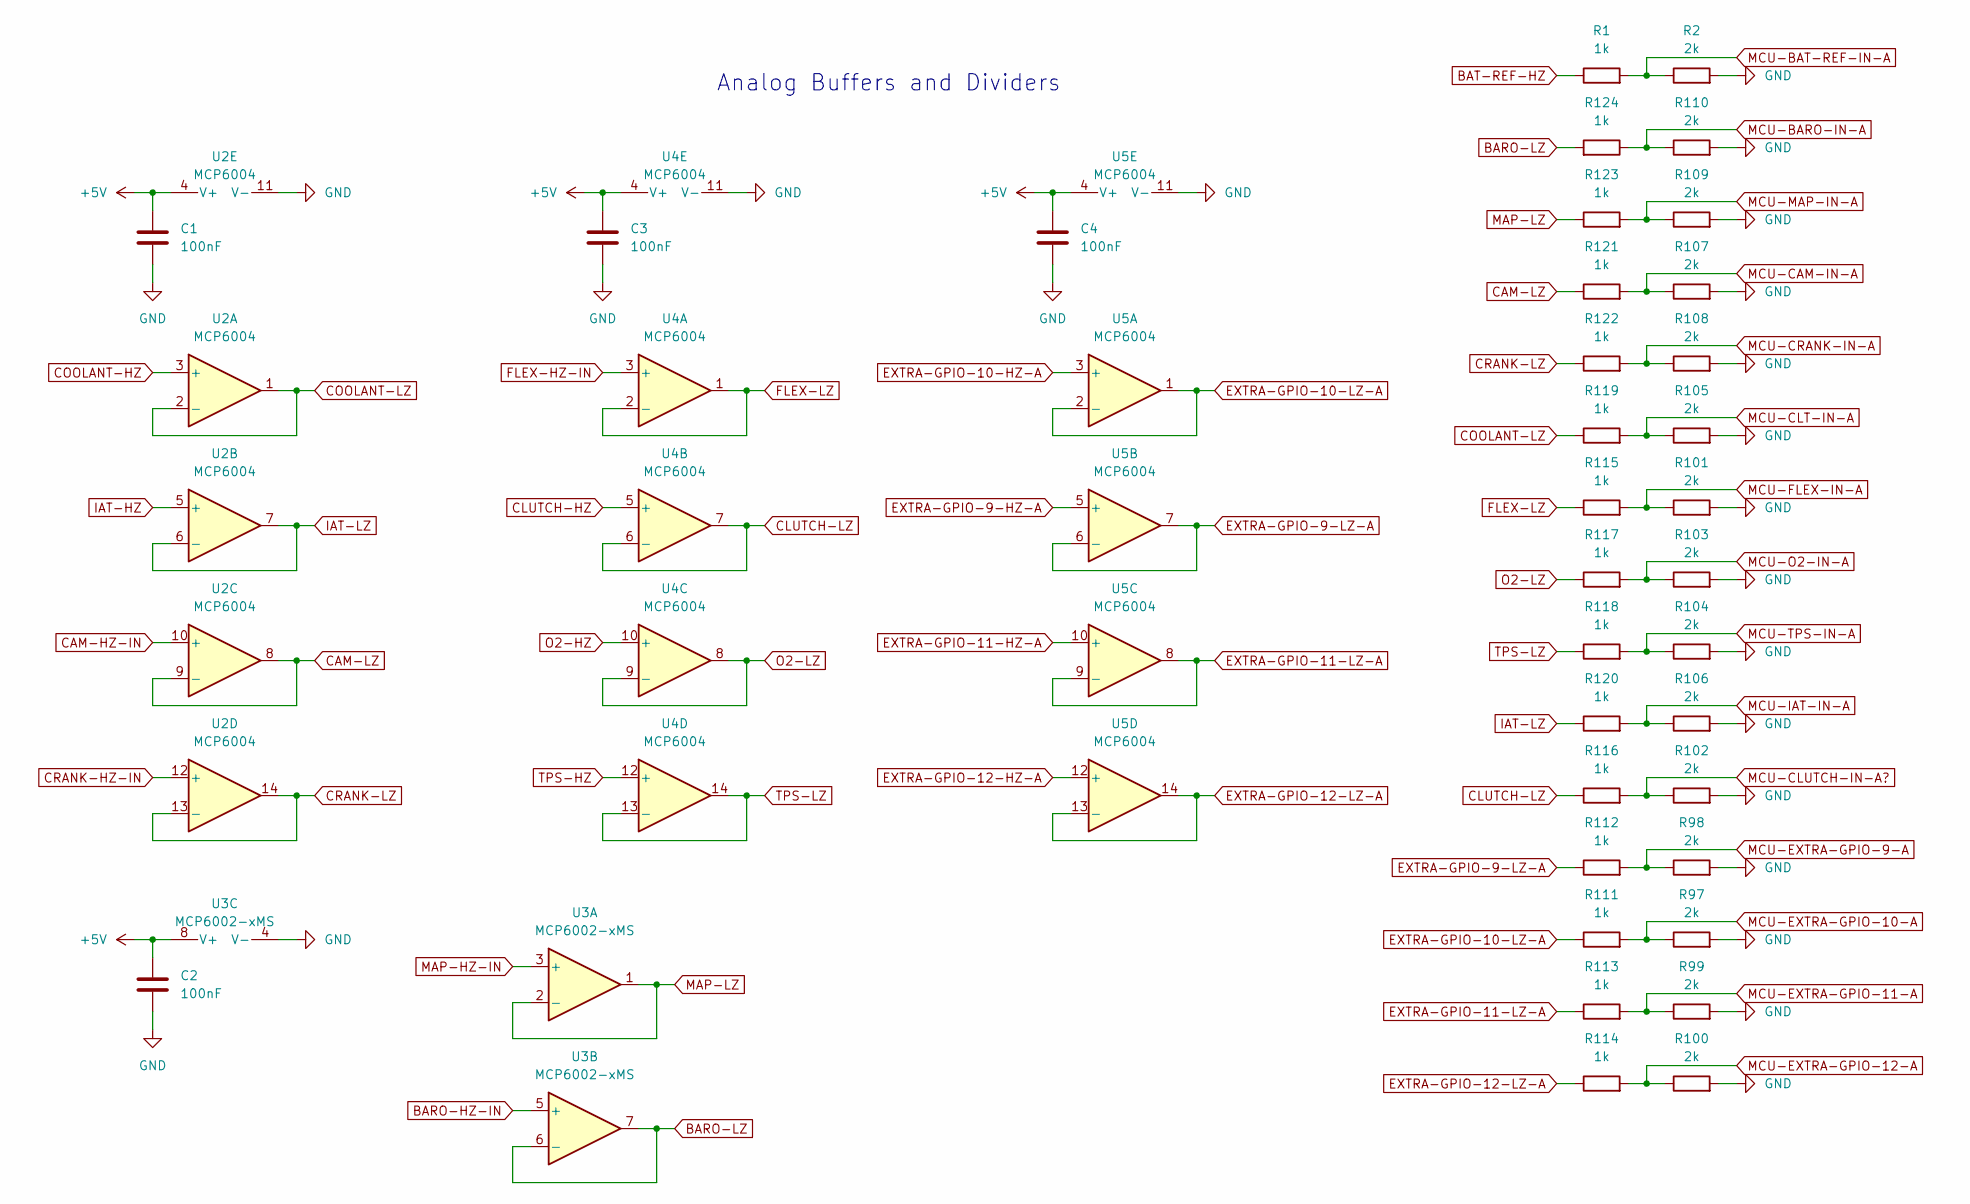
[picture p8: schematic stm32_conversion_analog_digital.kicad_sch]

Parts:
C1, C2, C3, C4: 100nF; C_0805_2012Metric
R1, R111, R112, R113, R114, R115, R116, R117, R118, R119, R120, R121, R122, R123, R124: 1k; R_0805_2012Metric
R2, R97, R98, R99, R100, R101, R102, R103, R104, R105, R106, R107, R108, R109, R110: 2k; R_0805_2012Metric
U2, U4, U5: MCP6004; TSSOP-14_4.4x5mm_P0.65mm
U3: MCP6002-xMS; TSSOP-8_4.4x3mm_P0.65mm

Connections:
+5V: C1.1, C2.1, C3.1, C4.1, U2.4 (V+), U3.8 (V+), U4.4 (V+), U5.4 (V+); also elsewhere on the board
BARO-HZ-IN: U3.5 (+); also elsewhere on the board
BARO-LZ: R124.2, U3.6 (-), U3.7
BAT-REF-HZ: R1.1; also elsewhere on the board
CAM-HZ-IN: U2.10 (+); also elsewhere on the board
CAM-LZ: R121.1, U2.8, U2.9 (-)
CLUTCH-HZ: U4.5 (+); also elsewhere on the board
CLUTCH-LZ: R116.1, U4.6 (-), U4.7
COOLANT-HZ: U2.3 (+); also elsewhere on the board
COOLANT-LZ: R119.1, U2.1, U2.2 (-)
CRANK-HZ-IN: U2.12 (+); also elsewhere on the board
CRANK-LZ: R122.1, U2.13 (-), U2.14
EXTRA-GPIO-9-HZ-A: U5.5 (+); also elsewhere on the board
EXTRA-GPIO-9-LZ-A: R112.1, U5.6 (-), U5.7
EXTRA-GPIO-10-HZ-A: U5.3 (+); also elsewhere on the board
EXTRA-GPIO-10-LZ-A: R111.1, U5.1, U5.2 (-)
EXTRA-GPIO-11-HZ-A: U5.10 (+); also elsewhere on the board
EXTRA-GPIO-11-LZ-A: R113.1, U5.8, U5.9 (-)
EXTRA-GPIO-12-HZ-A: U5.12 (+); also elsewhere on the board
EXTRA-GPIO-12-LZ-A: R114.1, U5.13 (-), U5.14
FLEX-HZ-IN: U4.3 (+); also elsewhere on the board
FLEX-LZ: R115.1, U4.1, U4.2 (-)
GND: C1.2, C2.2, C3.2, C4.2, R2.2, R97.2, R98.2, R99.2, R100.2, R101.2, R102.2, R103.2, R104.2, R105.2, R106.2, R107.2, R108.2, R109.2, R110.2, U2.11 (V-), U3.4 (V-), U4.11 (V-), U5.11 (V-); also elsewhere on the board
IAT-HZ: U2.5 (+); also elsewhere on the board
IAT-LZ: R120.1, U2.6 (-), U2.7
MAP-HZ-IN: U3.3 (+); also elsewhere on the board
MAP-LZ: R123.1, U3.1, U3.2 (-)
MCU-BARO-IN-A: R110.1, R124.1; also elsewhere on the board
MCU-BAT-REF-IN-A: R1.2, R2.1; also elsewhere on the board
MCU-CAM-IN-A: R107.1, R121.2; also elsewhere on the board
MCU-CLT-IN-A: R105.1, R119.2; also elsewhere on the board
MCU-CLUTCH-IN-A?: R102.1, R116.2; also elsewhere on the board
MCU-CRANK-IN-A: R108.1, R122.2; also elsewhere on the board
MCU-EXTRA-GPIO-9-A: R98.1, R112.2; also elsewhere on the board
MCU-EXTRA-GPIO-10-A: R97.1, R111.2; also elsewhere on the board
MCU-EXTRA-GPIO-11-A: R99.1, R113.2; also elsewhere on the board
MCU-EXTRA-GPIO-12-A: R100.1, R114.2; also elsewhere on the board
MCU-FLEX-IN-A: R101.1, R115.2; also elsewhere on the board
MCU-IAT-IN-A: R106.1, R120.2; also elsewhere on the board
MCU-MAP-IN-A: R109.1, R123.2; also elsewhere on the board
MCU-O2-IN-A: R103.1, R117.2; also elsewhere on the board
MCU-TPS-IN-A: R104.1, R118.2; also elsewhere on the board
O2-HZ: U4.10 (+); also elsewhere on the board
O2-LZ: R117.1, U4.8, U4.9 (-)
TPS-HZ: U4.12 (+); also elsewhere on the board
TPS-LZ: R118.1, U4.13 (-), U4.14

Notes on the sheet:
Analog Buffers and Dividers

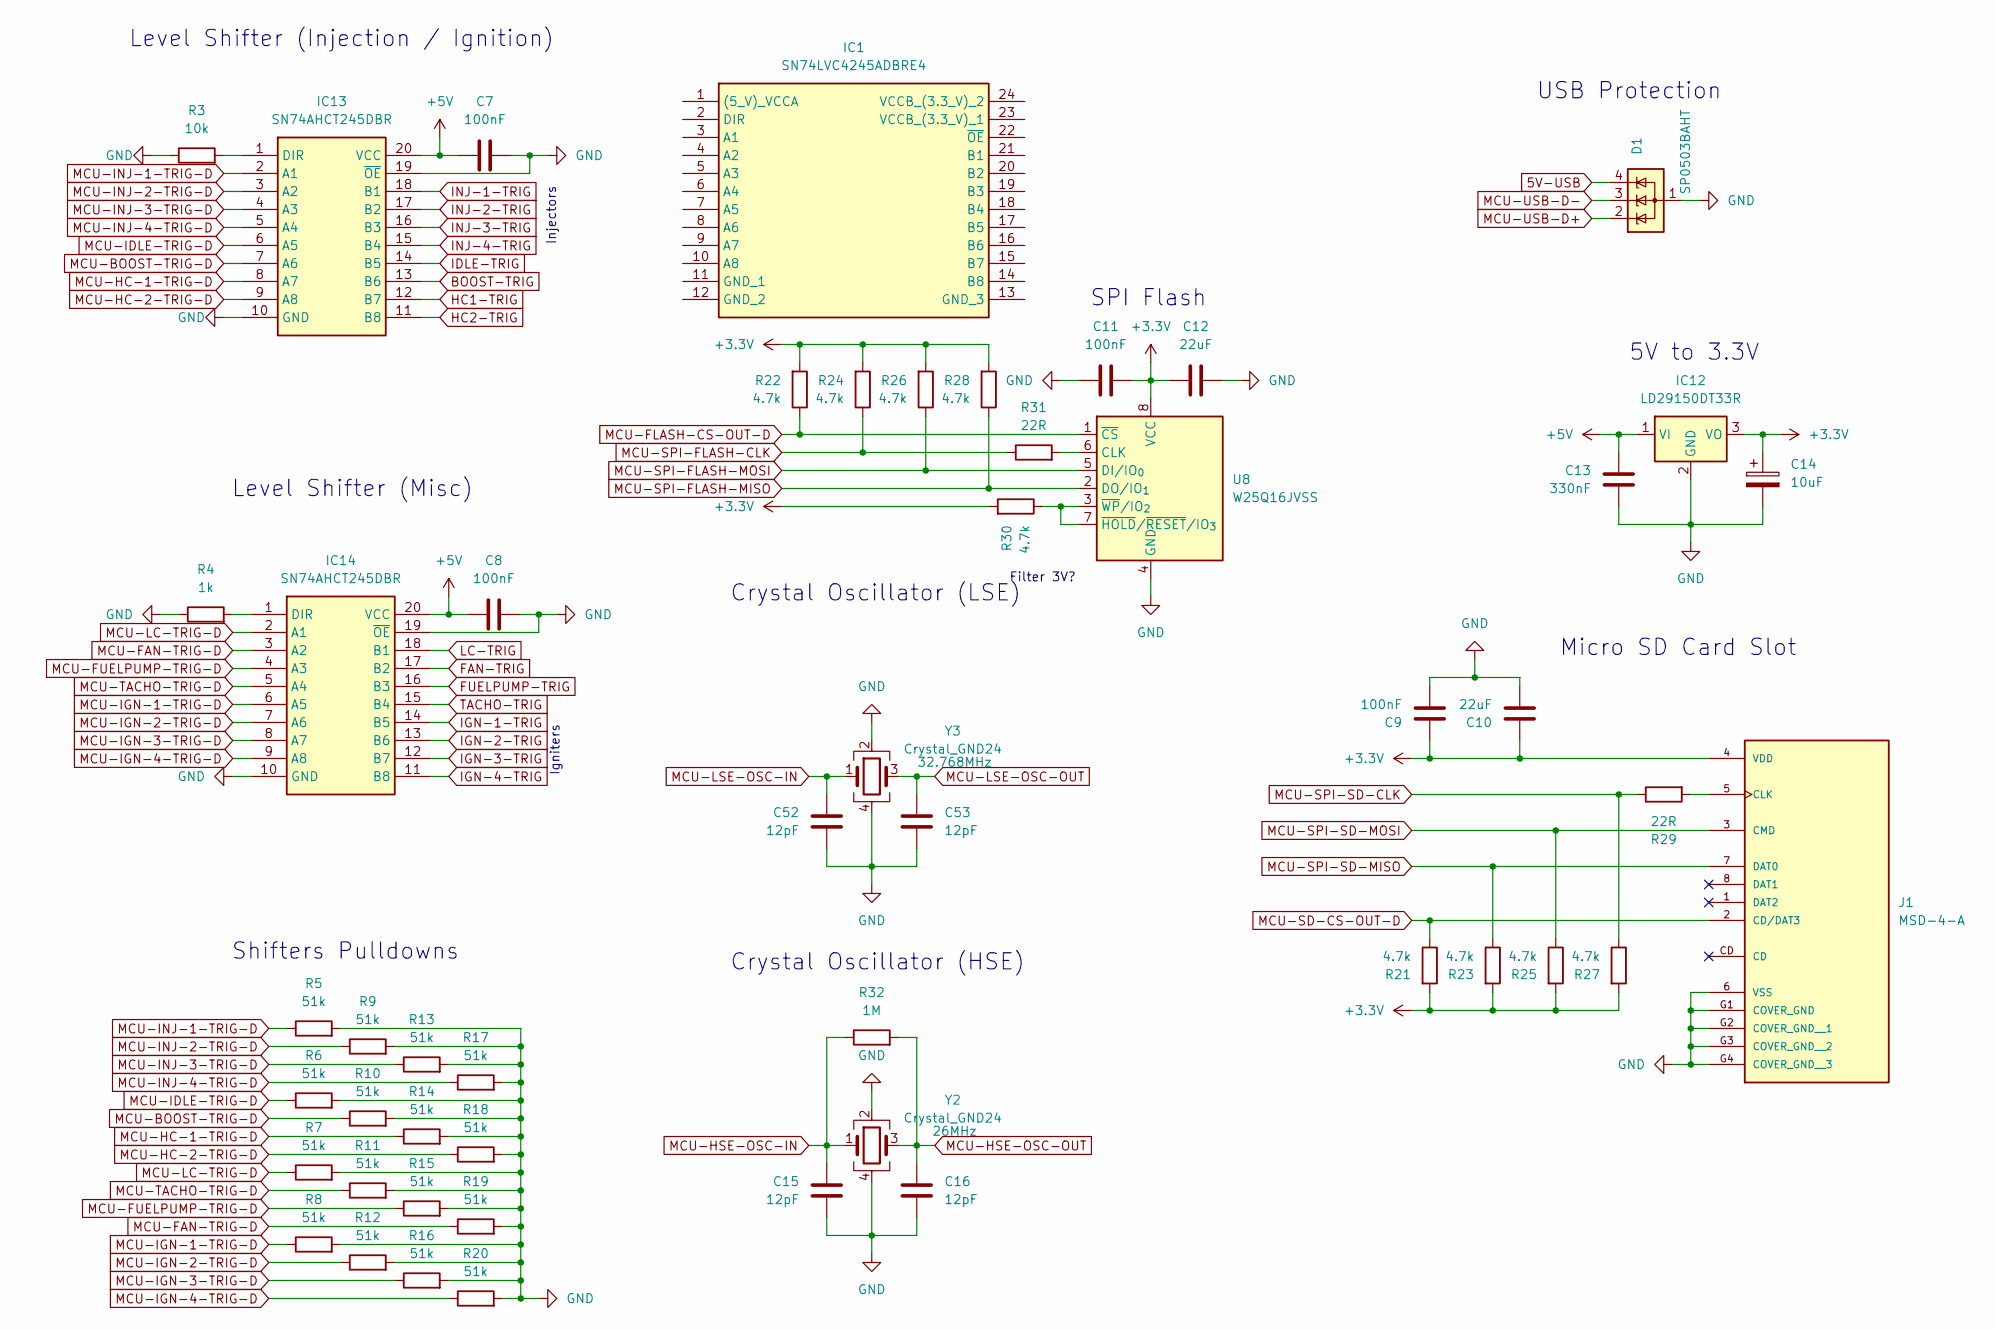
[picture p9: schematic stm32_conversion_misc.kicad_sch]

Parts:
C7, C8, C9, C11: 100nF; C_0805_2012Metric
C10, C12: 22uF; C_0805_2012Metric
C13: 330nF; C_0805_2012Metric
C14: 10uF; CP_EIA-3528-12_Kemet-T
C15, C16, C52, C53: 12pF; C_0805_2012Metric
D1: SP0503BAHT; SOT-143
IC1: SN74LVC4245ADBRE4; SOP65P780X200-24N; Manufacturer_Part_Number SN74LVC4245ADBRE4; Mouser Part Number 595-SN74LVC4245ADBRE
IC12: LD29150DT33R; TO-252-2; Manufacturer_Part_Number LD29150DT33R; Mouser Part Number 511-LD29150DT33R
IC13, IC14: SN74AHCT245DBR; SOP65P780X200-20N; Manufacturer_Part_Number SN74AHCT245DBR; Mouser Part Number 595-SN74AHCT245DBR
J1: MSD-4-A; CUI_MSD-4-A; PARTREV 1.0
R3: 10k; R_0805_2012Metric
R4: 1k; R_0805_2012Metric
R5, R6, R7, R8, R9, R10, R11, R12, R13, R14, R15, R16, R17, R18, R19, R20: 51k; R_0805_2012Metric
R21, R22, R23, R24, R25, R26, R27, R28, R30: 4.7k; R_0805_2012Metric
R29, R31: 22R; R_0805_2012Metric
R32: 1M; R_0805_2012Metric
U8: W25Q16JVSS; SOIC-8_5.3x5.3mm_P1.27mm
Y2, Y3: Crystal_GND24; Crystal_SMD_2016-4Pin_2.0x1.6mm

Connections:
5V-USB: D1.4 (K); also elsewhere on the board
+3.3V: C9.2, C10.2, C11.2, C12.1, C14.1, IC12.3 (VO), J1.4 (VDD), R21.2, R22.2, R23.2, R24.2, R25.2, R26.2, R27.2, R28.2, R30.2, U8.8 (VCC); also elsewhere on the board
+5V: C7.1, C8.1, C13.1, IC12.1 (VI), IC13.20 (VCC), IC14.20 (VCC); also elsewhere on the board
BOOST-TRIG: IC13.13 (B6); also elsewhere on the board
FAN-TRIG: IC14.17 (B2); also elsewhere on the board
FUELPUMP-TRIG: IC14.16 (B3); also elsewhere on the board
GND: C7.2, C8.2, C9.1, C10.1, C11.1, C12.2, C13.2, C14.2, C15.2, C16.2, C52.2, C53.2, D1.1 (A), IC12.2 (GND), IC13.10 (GND), IC13.19 (~OE), IC14.10 (GND), IC14.19 (~OE), J1.6 (VSS), J1.G1 (COVER_GND), J1.G2 (COVER_GND__1), J1.G3 (COVER_GND__2), J1.G4 (COVER_GND__3), R3.1, R4.1, R5.2, R6.2, R7.2, R8.2, R9.2, R10.2, R11.2, R12.2, R13.2, R14.2, R15.2, R16.2, R17.2, R18.2, R19.2, R20.2, U8.4 (GND), Y2.2, Y2.4, Y3.2, Y3.4; also elsewhere on the board
HC1-TRIG: IC13.12 (B7); also elsewhere on the board
HC2-TRIG: IC13.11 (B8); also elsewhere on the board
IDLE-TRIG: IC13.14 (B5); also elsewhere on the board
IGN-1-TRIG: IC14.14 (B5); also elsewhere on the board
IGN-2-TRIG: IC14.13 (B6); also elsewhere on the board
IGN-3-TRIG: IC14.12 (B7); also elsewhere on the board
IGN-4-TRIG: IC14.11 (B8); also elsewhere on the board
INJ-1-TRIG: IC13.18 (B1); also elsewhere on the board
INJ-2-TRIG: IC13.17 (B2); also elsewhere on the board
INJ-3-TRIG: IC13.16 (B3); also elsewhere on the board
INJ-4-TRIG: IC13.15 (B4); also elsewhere on the board
LC-TRIG: IC14.18 (B1); also elsewhere on the board
MCU-BOOST-TRIG-D: IC13.7 (A6), R10.1; also elsewhere on the board
MCU-FAN-TRIG-D: IC14.3 (A2), R19.1; also elsewhere on the board
MCU-FLASH-CS-OUT-D: R22.1, U8.1 (~CS); also elsewhere on the board
MCU-FUELPUMP-TRIG-D: IC14.4 (A3), R15.1; also elsewhere on the board
MCU-HC-1-TRIG-D: IC13.8 (A7), R14.1; also elsewhere on the board
MCU-HC-2-TRIG-D: IC13.9 (A8), R18.1; also elsewhere on the board
MCU-HSE-OSC-IN: C15.1, R32.1, Y2.1; also elsewhere on the board
MCU-HSE-OSC-OUT: C16.1, R32.2, Y2.3; also elsewhere on the board
MCU-IDLE-TRIG-D: IC13.6 (A5), R6.1; also elsewhere on the board
MCU-IGN-1-TRIG-D: IC14.6 (A5), R8.1; also elsewhere on the board
MCU-IGN-2-TRIG-D: IC14.7 (A6), R12.1; also elsewhere on the board
MCU-IGN-3-TRIG-D: IC14.8 (A7), R16.1; also elsewhere on the board
MCU-IGN-4-TRIG-D: IC14.9 (A8), R20.1; also elsewhere on the board
MCU-INJ-1-TRIG-D: IC13.2 (A1), R5.1; also elsewhere on the board
MCU-INJ-2-TRIG-D: IC13.3 (A2), R9.1; also elsewhere on the board
MCU-INJ-3-TRIG-D: IC13.4 (A3), R13.1; also elsewhere on the board
MCU-INJ-4-TRIG-D: IC13.5 (A4), R17.1; also elsewhere on the board
MCU-LC-TRIG-D: IC14.2 (A1), R7.1; also elsewhere on the board
MCU-LSE-OSC-IN: C52.1, Y3.1; also elsewhere on the board
MCU-LSE-OSC-OUT: C53.1, Y3.3; also elsewhere on the board
MCU-SD-CS-OUT-D: J1.2 (CD/DAT3), R21.1; also elsewhere on the board
MCU-SPI-FLASH-CLK: R24.1, R31.1; also elsewhere on the board
MCU-SPI-FLASH-MISO: R28.1, U8.2 (DO/IO_{1}); also elsewhere on the board
MCU-SPI-FLASH-MOSI: R26.1, U8.5 (DI/IO_{0}); also elsewhere on the board
MCU-SPI-SD-CLK: R27.1, R29.1; also elsewhere on the board
MCU-SPI-SD-MISO: J1.7 (DAT0), R23.1; also elsewhere on the board
MCU-SPI-SD-MOSI: J1.3 (CMD), R25.1; also elsewhere on the board
MCU-TACHO-TRIG-D: IC14.5 (A4), R11.1; also elsewhere on the board
MCU-USB-D+: D1.2 (K); also elsewhere on the board
MCU-USB-D-: D1.3 (K); also elsewhere on the board
unnamed: IC13.1 (DIR), R3.2
unnamed: IC14.1 (DIR), R4.2
unnamed: J1.5 (CLK), R29.2
unnamed: R31.2, U8.6 (CLK)
unnamed: R30.1, U8.3 (~WP/IO_{2}), U8.7 (~HOLD/~RESET/IO_{3})
TACHO-TRIG: IC14.15 (B4); also elsewhere on the board

Notes on the sheet:
5V to 3.3V
Filter 3V?
USB Protection
Shifters Pulldowns
Injectors
Crystal Oscillator (HSE)
Level Shifter (Injection / Ignition)
SPI Flash
Level Shifter (Misc)
Igniters
Crystal Oscillator (LSE)
Micro SD Card Slot

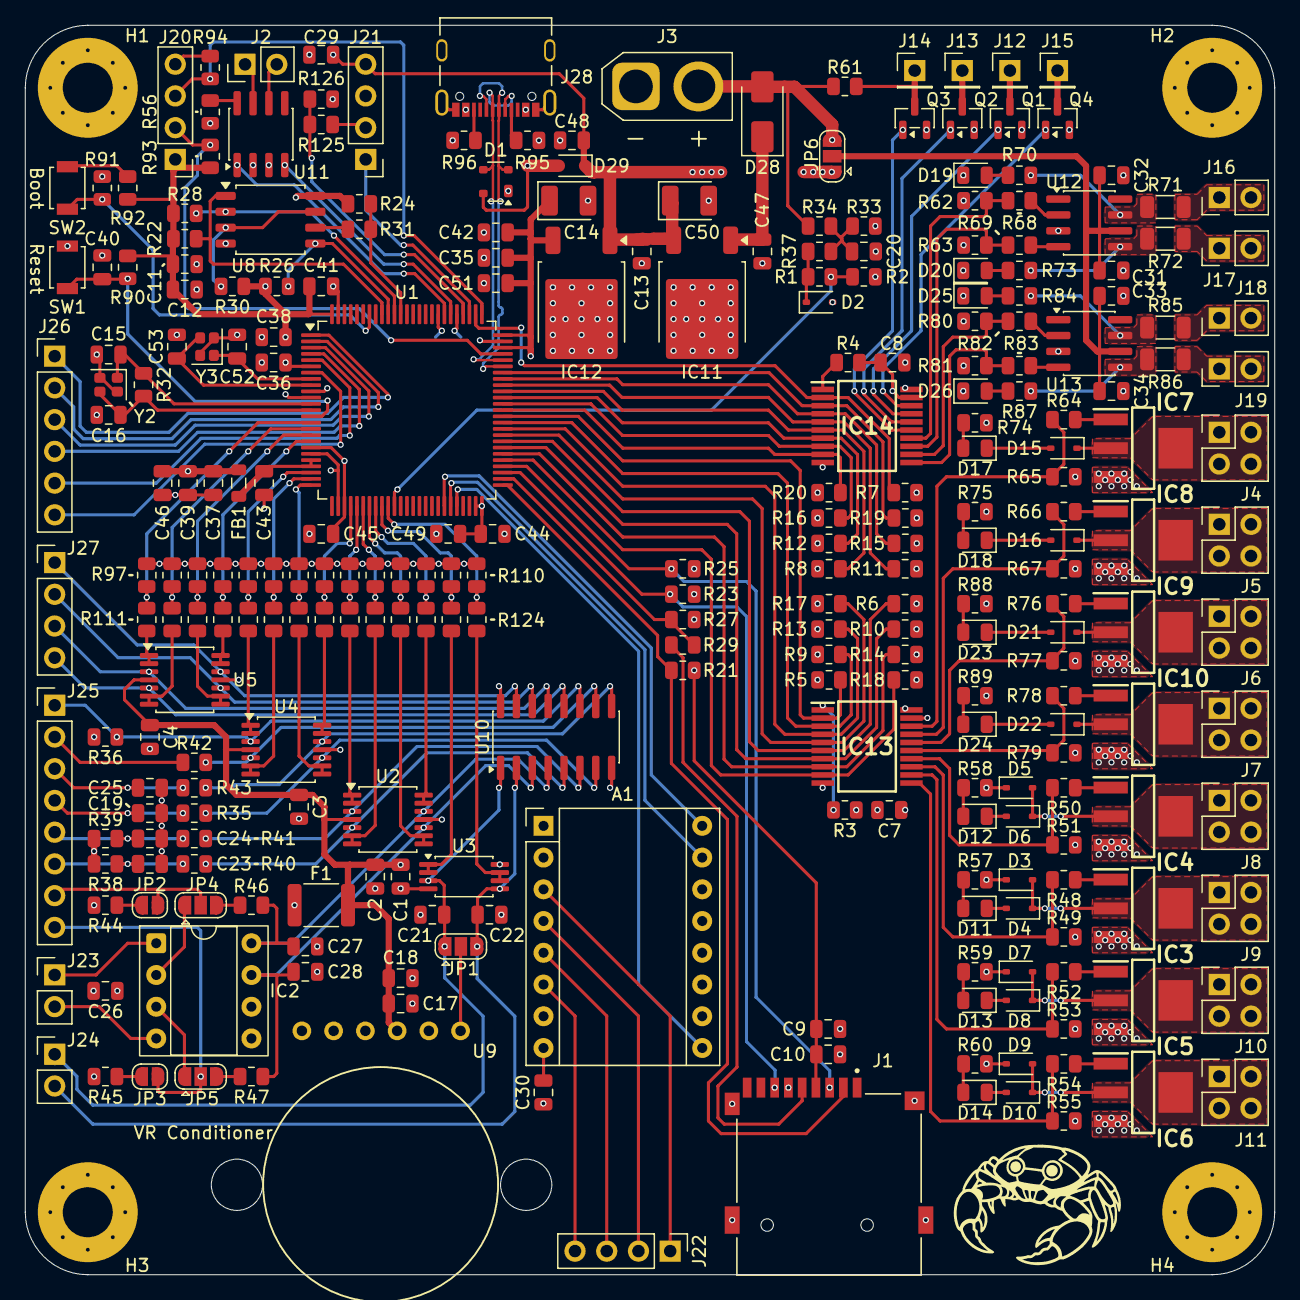
[picture p10: board speeday.kicad_pcb from above]

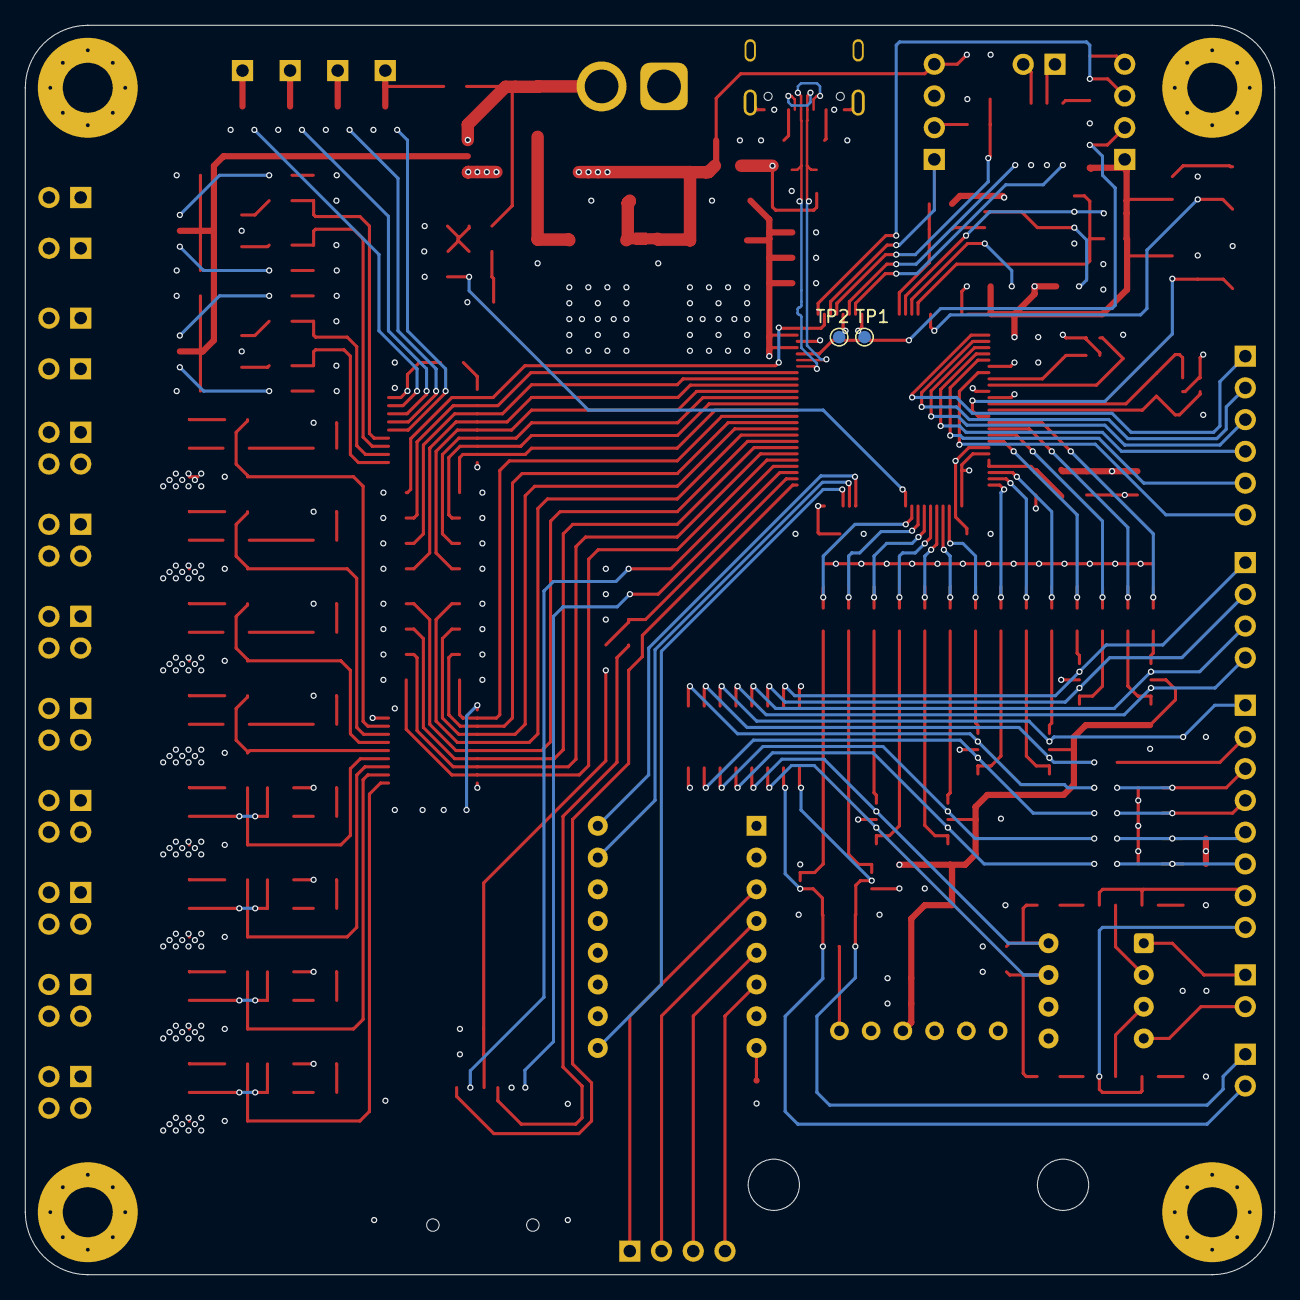
[picture p11: board speeday.kicad_pcb from below]

Board: 4 copper layers, 100.0 x 100.0 mm, 281 parts (2 on the bottom side), 204 nets.
