Thrathra/Speeduino-Daytona/(commit log)

2025-04-03 Populate Board
    [Fuel_Ignition.kicad_sch, connector.kicad_sch, fuel_ignition.kicad_sch, inputs.kicad_sch, outputs.kicad_sch, power.kicad_sch, proto.kicad_sch, speeday.kicad_pcb]
2025-04-18 Add additional IOs
    [connector.kicad_sch, fuel_ignition.kicad_sch, inputs.kicad_sch, outputs.kicad_sch, speeday.kicad_pcb, speeday.kicad_sch, stm32_conversion.kicad_sch]
2025-05-19 Pre MCU switch
    [connector.kicad_sch, fuel_ignition.kicad_sch, inputs.kicad_sch, outputs.kicad_sch, power.kicad_sch, speeday.kicad_pcb, speeday.kicad_sch, stm32_conversion.kicad_sch]
2025-05-28 Fix MCU decoupling capacitors
    [power.kicad_sch, speeday.kicad_pcb, speeday.kicad_sch]
2025-05-31 Update from Speeduino Discord suggestions (thanks to Detonator)
    [connector.kicad_sch, inputs.kicad_sch, power.kicad_sch, speeday.kicad_pcb, stm32_conversion.kicad_sch]
2025-06-30 Fully connect all components
    [connectors.kicad_sch, fuel_ignition.kicad_sch, inputs.kicad_sch, outputs.kicad_sch, power.kicad_sch, speeday.kicad_pcb, speeday.kicad_sch, stm32_conversion.kicad_sch]
2025-11-04 Fix power traces width and add logo
    [connectors.kicad_sch, speeday.kicad_pcb]
2025-11-09 Updated reference layout
    [connectors.kicad_sch, fuel_ignition.kicad_sch, inputs.kicad_sch, outputs.kicad_sch, power.kicad_sch, speeday.kicad_pcb, speeday.kicad_sch, stm32_conversion_analog_digital.kicad_sch]
2026-06-29 Change power layout, add low frequency crystal
    [connectors.kicad_sch, fuel_ignition.kicad_sch, inputs.kicad_sch, outputs.kicad_sch, power.kicad_sch, speeday.kicad_pcb, speeday.kicad_sch, stm32_conversion_analog_digital.kicad_sch]
2026-07-01 Replace level shifters, rewire for spacing
    [speeday.kicad_pcb, stm32_conversion_misc.kicad_sch]
